jaowens14/GR-LRR-PCB/GR-LRR-ESTOP-PCB/electronics_libraries/S4B-XH-SM4-TB/S4B-XH-SM4-TB_LF__SN_.stp

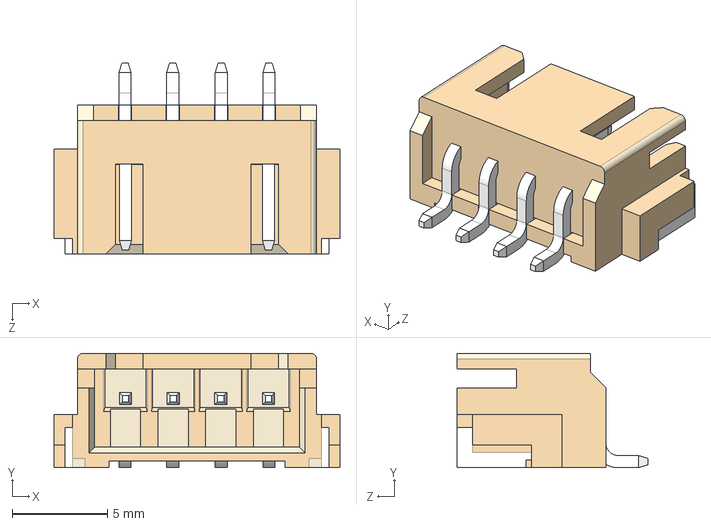
[picture p1: CAD file, 2023-12-06]
GR-LRR-ESTOP-PCB/electronics_libraries/S4B-XH-SM4-TB/S4B-XH-SM4-TB_LF__SN_.stp
15.0 x 6.00 x 10.0 mm
