jaowens14/GR-LRR-PCB/GR-LRR-POWER-PCB-HIGH-VOLTAGE/electronics_libraries/2604-1102/2604-1102.stp

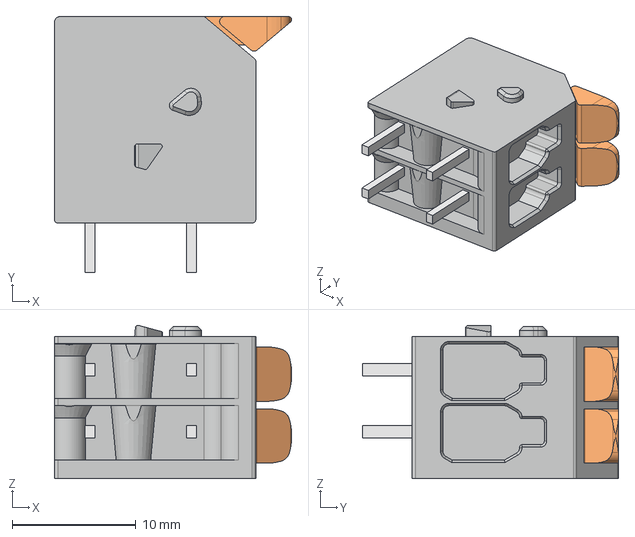
[picture p2: CAD file, 2023-10-17]
GR-LRR-POWER-PCB-HIGH-VOLTAGE/electronics_libraries/2604-1102/2604-1102.stp
19.2 x 20.7 x 12.4 mm
