jaowens14/GR-LRR-PCB/GR-LRR-POWER-PCB-HIGH-VOLTAGE/electronics_libraries/DF40HC(3.5)-80DS-0.4V(51)/DF40HC(3.5)-80DS.stp

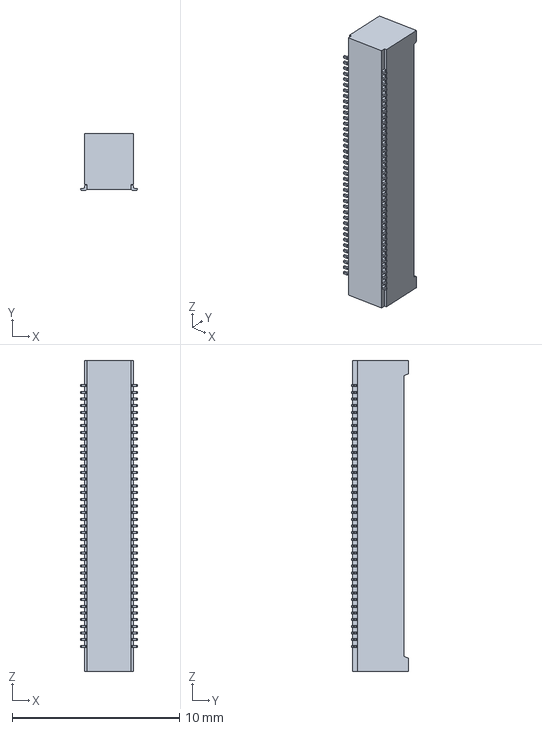
[picture p3: CAD file, 2023-10-17]
GR-LRR-POWER-PCB-HIGH-VOLTAGE/electronics_libraries/DF40HC(3.5)-80DS-0.4V(51)/DF40HC(3.5)-80DS.stp
3.38 x 3.40 x 18.6 mm
