jaowens14/GR-LRR-PCB/GR-LRR-POWER-PCB-HIGH-VOLTAGE/electronics_libraries/FX30B-4P-3.81DSA25/FX30B-4P-3.81DSA25.stp

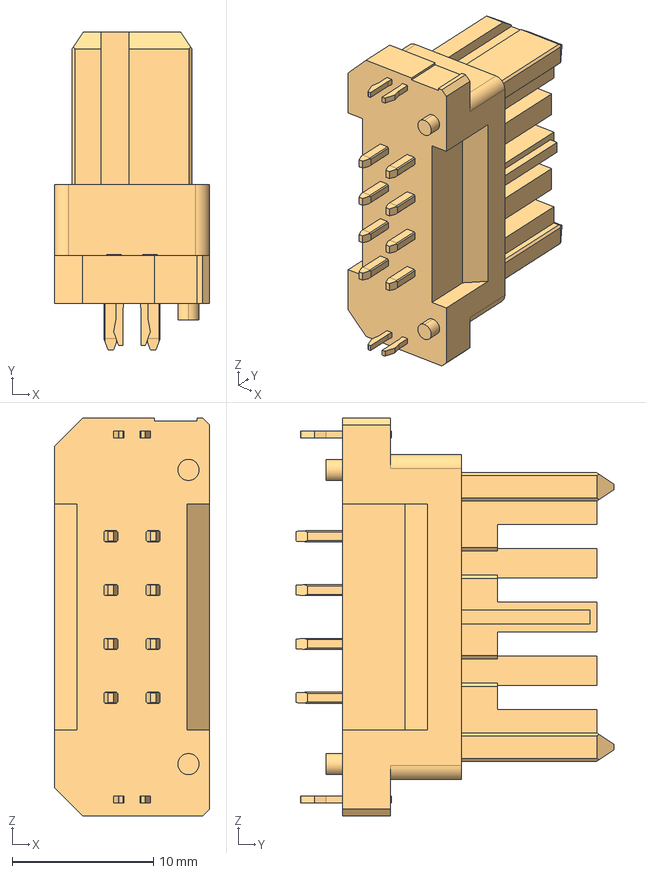
[picture p4: CAD file, 2023-12-06]
GR-LRR-POWER-PCB-HIGH-VOLTAGE/electronics_libraries/FX30B-4P-3.81DSA25/FX30B-4P-3.81DSA25.stp
11.0 x 22.5 x 28.2 mm
