jaowens14/GR-LRR-PCB/GR-LRR-POWER-PCB-HIGH-VOLTAGE/electronics_libraries/FX30B-4S-3.81DSA/FX30B-4S-3.81DSA.stp

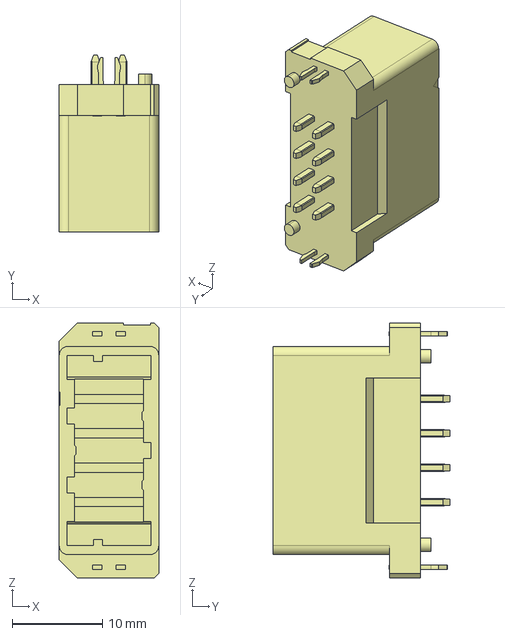
[picture p5: CAD file, 2023-12-06]
GR-LRR-POWER-PCB-HIGH-VOLTAGE/electronics_libraries/FX30B-4S-3.81DSA/FX30B-4S-3.81DSA.stp
11.0 x 19.6 x 28.2 mm
