jaowens14/GR-LRR-PCB/GR-LRR-POWER-PCB-HIGH-VOLTAGE/electronics_libraries/G5LE-14-DC5/G5LE-14-DC5.stp

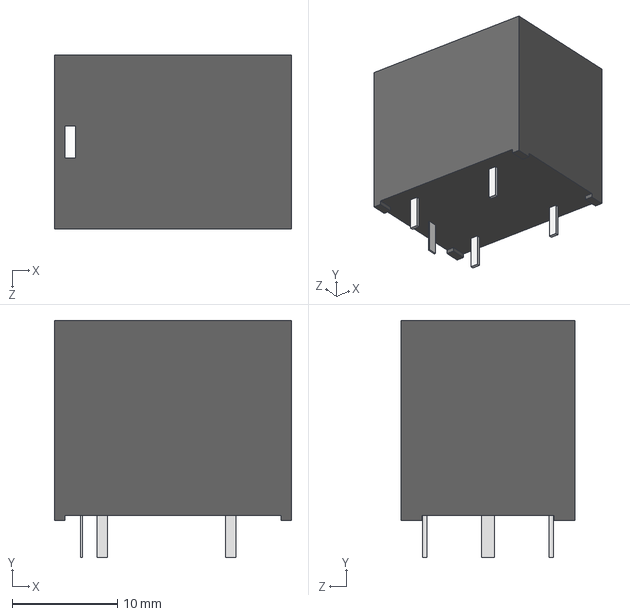
[picture p6: CAD file, 2023-10-31]
GR-LRR-POWER-PCB-HIGH-VOLTAGE/electronics_libraries/G5LE-14-DC5/G5LE-14-DC5.stp
22.5 x 22.5 x 16.5 mm
