jaowens14/GR-LRR-PCB/GR-LRR-POWER-PCB-HIGH-VOLTAGE/electronics_libraries/UWE-245-Q12PB-C/UWE-24_5-Q12PB-C.stp

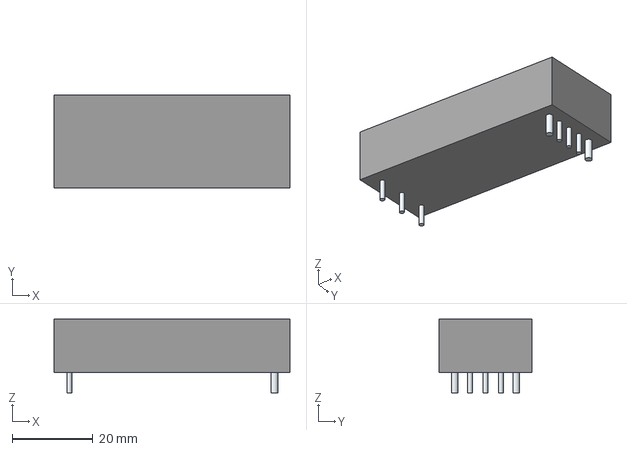
[picture p7: CAD file, 2023-10-31]
GR-LRR-POWER-PCB-HIGH-VOLTAGE/electronics_libraries/UWE-245-Q12PB-C/UWE-24_5-Q12PB-C.stp
58.4 x 22.9 x 18.3 mm
Leads
