jaowens14/GR-LRR-PCB/GR-LRR-POWER-PCB-HIGH-VOLTAGE/electronics_libraries/VSMA1085250/VSMA1085250.stp

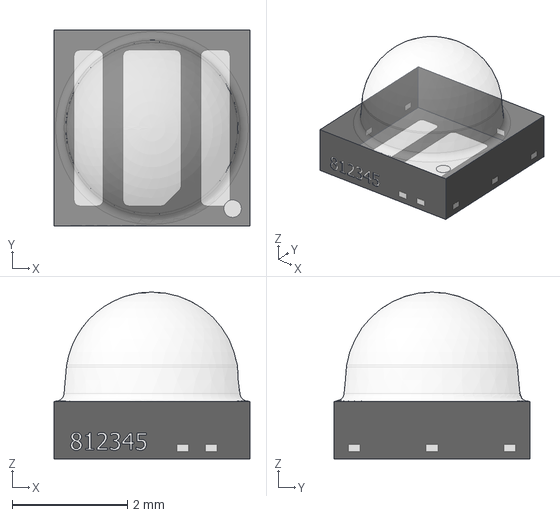
[picture p8: CAD file, 2023-10-17]
GR-LRR-POWER-PCB-HIGH-VOLTAGE/electronics_libraries/VSMA1085250/VSMA1085250.stp
3.40 x 3.40 x 2.90 mm
