jaowens14/GR-LRR-PCB/GR-LRR-POWER-PCB-HIGH-VOLTAGE/electronics_libraries/XA1E-BV302-R/XA1E-BV302-R.stp

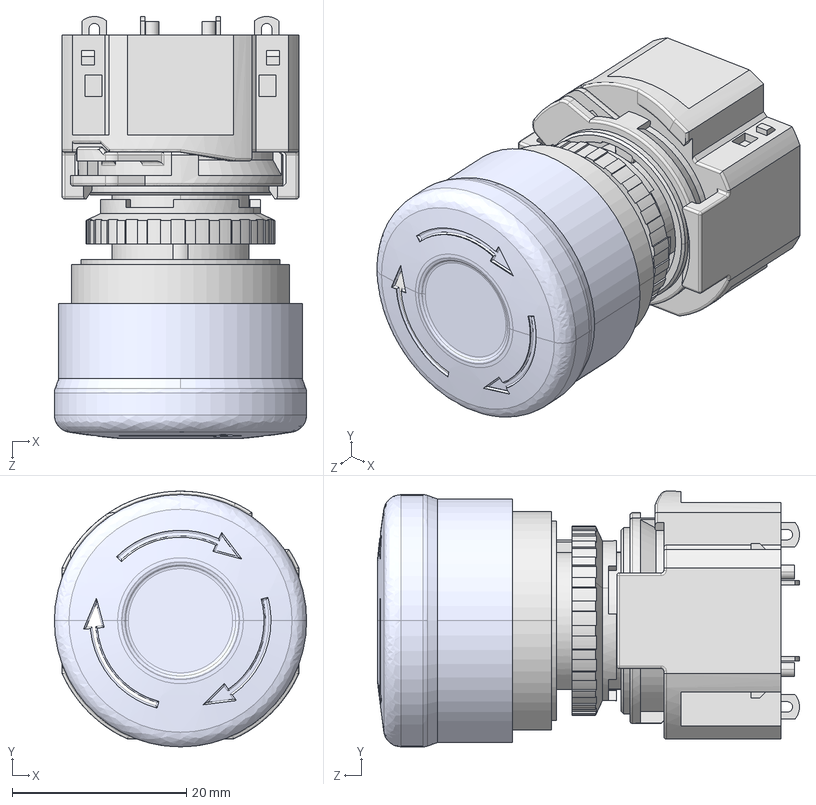
[picture p9: CAD file, 2023-10-31]
GR-LRR-POWER-PCB-HIGH-VOLTAGE/electronics_libraries/XA1E-BV302-R/XA1E-BV302-R.stp
29.0 x 29.4 x 48.5 mm
XA-BODY-V-Y
XA-HANDLE-[B][L]V
XA-LOCK-NUT
XA-Cxx
