jaowens14/GR-LRR-PCB/GR-LRR-POWER-PCB-HIGH-VOLTAGE/GR-LRR-POWER-PCB-HIGH-VOLTAGE.SLDPRT

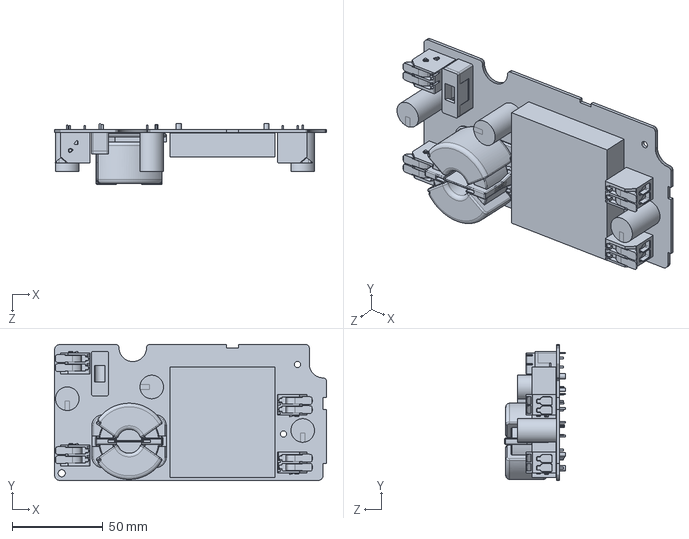
[picture p10: CAD file, 2024-03-25]
GR-LRR-POWER-PCB-HIGH-VOLTAGE/GR-LRR-POWER-PCB-HIGH-VOLTAGE.SLDPRT
150.0 x 75.0 x 33.5 mm
