jaowens14/GR-LRR-PCB/GR-LRR-POWER-PCB-INPUT/electronics_libraries/SISB46DN-T1-GE3/SISB46DN-T1-GE3.stp

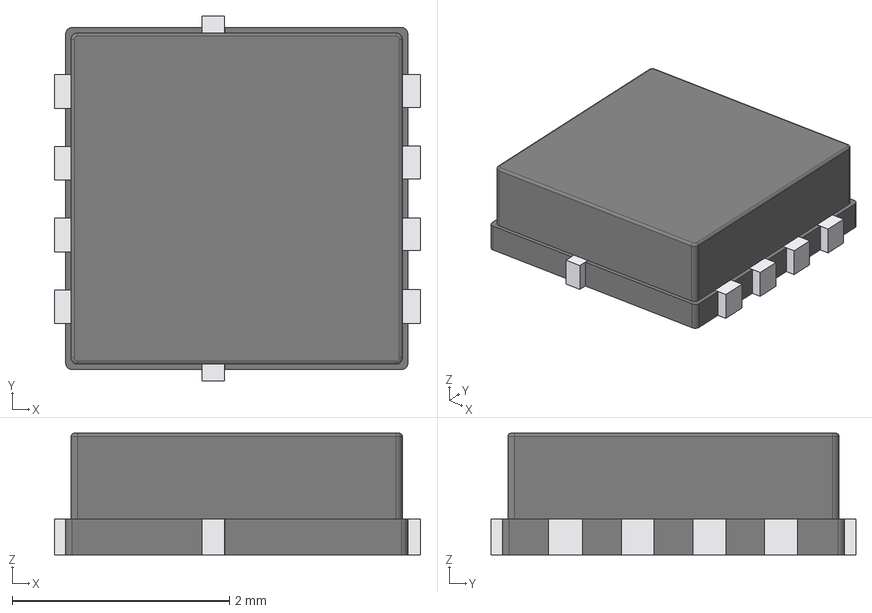
[picture p11: CAD file, 2024-03-25]
GR-LRR-POWER-PCB-INPUT/electronics_libraries/SISB46DN-T1-GE3/SISB46DN-T1-GE3.stp
3.37 x 3.36 x 1.12 mm
