jaowens14/GR-LRR-PCB/GR-LRR-POWER-PCB-LOW-VOLTAGE/electronics_libraries/UEI15-033-Q12P-C/UEI15-033-Q12P-C.stp

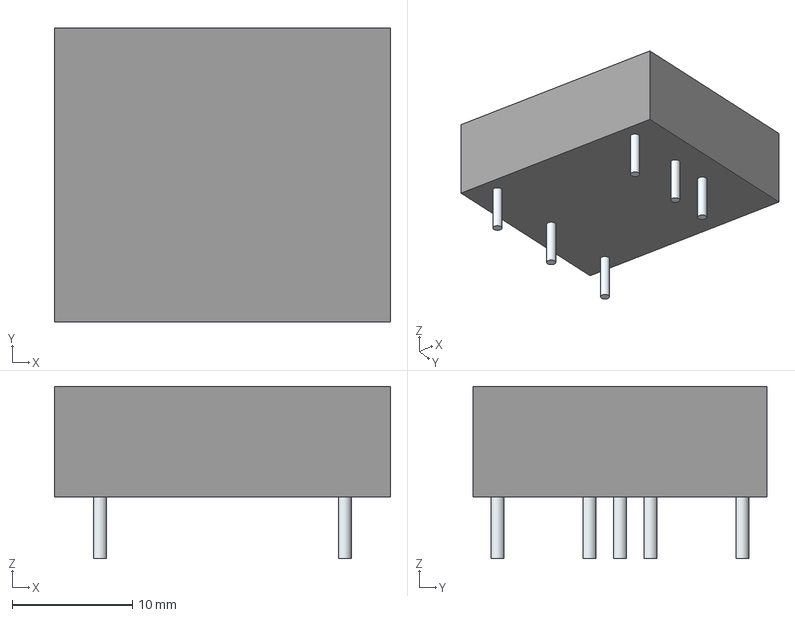
[picture p12: CAD file, 2024-03-25]
GR-LRR-POWER-PCB-LOW-VOLTAGE/electronics_libraries/UEI15-033-Q12P-C/UEI15-033-Q12P-C.stp
27.9 x 24.4 x 14.3 mm
Leads
