jaowens14/GR-LRR-PCB/GR-LRR-POWER-PCB-LOW-VOLTAGE/electronics_libraries/UWS-510-Q12P-C/UWS-510-Q12P-C.stp

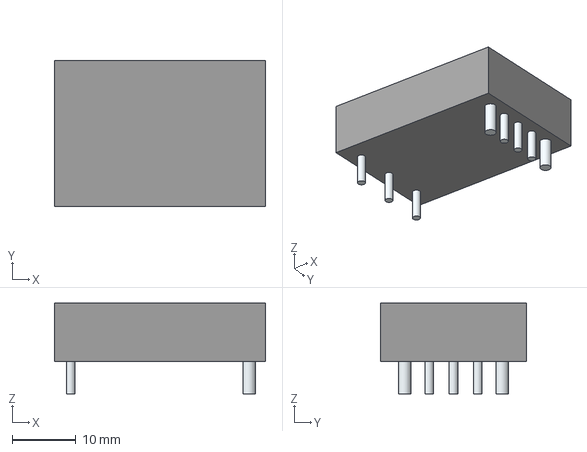
[picture p13: CAD file, 2024-03-25]
GR-LRR-POWER-PCB-LOW-VOLTAGE/electronics_libraries/UWS-510-Q12P-C/UWS-510-Q12P-C.stp
33.0 x 22.9 x 14.2 mm
Leads x 8
