jaowens14/GR-LRR-PCB/GR-LRR-POWER-PCB-LOW-VOLTAGE/GR-LRR-POWER-PCB.SLDPRT

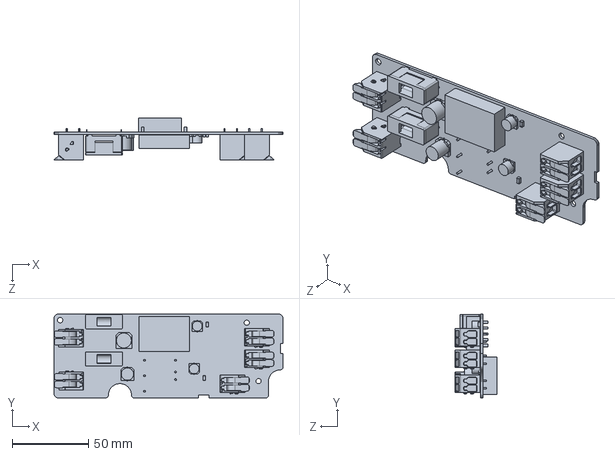
[picture p14: CAD file, 2024-03-25]
GR-LRR-POWER-PCB-LOW-VOLTAGE/GR-LRR-POWER-PCB.SLDPRT
150.0 x 55.0 x 27.7 mm
