jaowens14/GR-LRR-PCB/GR-LRR-POWER/GR-LRR-POWER.step

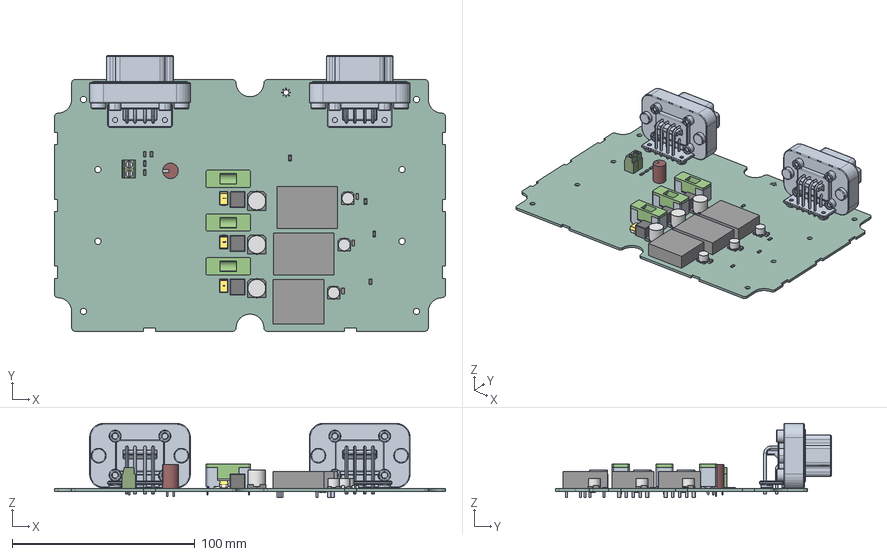
[picture p15: CAD file, 2024-08-06]
GR-LRR-POWER/GR-LRR-POWER.step
213.7 x 150.7 x 40.5 mm
CTSM_TCM2NKKO_7343_L7.6W4.6H4.3T0.13S1.3F2.5A3.6B0.65P1.7R1X0.2 x 3
R_1206_3216Metric x 11
696108003002 (rev1) x 3
ASSEMBLY x 3
C-DT13-08PB x 2
C_1206_3216Metric x 3
CQ assembly x 3
GR-LRR-POWER_PCB
