jaowens14/GR-LRR-PCB/(list of files, cad)

Other CAD files:
GR-LRR-POWER-PCB-HIGH-VOLTAGE/electronics_libraries/047700/047700.stp
GR-LRR-POWER-PCB-HIGH-VOLTAGE/electronics_libraries/696108003002/696108003002.stp
GR-LRR-POWER-PCB-HIGH-VOLTAGE/electronics_libraries/QSB30024S24/QSB30024S24.stp
GR-LRR-POWER-PCB-HIGH-VOLTAGE/electronics_libraries/TPS61021ADSGR/TPS61021ADSGR.stp
GR-LRR-POWER-PCB-INPUT/electronics_libraries/047700/047700.stp
GR-LRR-POWER-PCB-INPUT/electronics_libraries/QSB30024S24/QSB30024S24.stp
GR-LRR-POWER-PCB-INPUT/electronics_libraries/TPS61021ADSGR/TPS61021ADSGR.stp
GR-LRR-POWER-PCB-LOW-VOLTAGE/electronics_libraries/047700/047700.stp
GR-LRR-POWER-PCB-LOW-VOLTAGE/electronics_libraries/696108003002/696108003002.stp
GR-LRR-POWER-PCB-LOW-VOLTAGE/electronics_libraries/QSB30024S24/QSB30024S24.stp
GR-LRR-POWER-PCB-LOW-VOLTAGE/electronics_libraries/TPS61021ADSGR/TPS61021ADSGR.stp
OLD REVS/GR-LRR-CONTROL-PCB/electronics_libraries/047700/047700.stp
OLD REVS/GR-LRR-CONTROL-PCB/electronics_libraries/10018783_10101TLF/10018783-10101TLF.step
OLD REVS/GR-LRR-CONTROL-PCB/electronics_libraries/100PX220MEFC12.5X20/CAP_PKPZ_12P5X20_LOW_RUB.step
OLD REVS/GR-LRR-CONTROL-PCB/electronics_libraries/212520-1002/212520-1002.stp
OLD REVS/GR-LRR-CONTROL-PCB/electronics_libraries/2601_1112/2601-1112.stp
OLD REVS/GR-LRR-CONTROL-PCB/electronics_libraries/2604-3108/2604-3108.stp
OLD REVS/GR-LRR-CONTROL-PCB/electronics_libraries/43045-0212/43045-0212.stp
OLD REVS/GR-LRR-CONTROL-PCB/electronics_libraries/43045-1012/43045-1012.stp
OLD REVS/GR-LRR-CONTROL-PCB/electronics_libraries/50ZLH100MEFC8X11_5/CAP_YX_8X11P5_RUB.step
OLD REVS/GR-LRR-CONTROL-PCB/electronics_libraries/696108003002/696108003002.stp
OLD REVS/GR-LRR-CONTROL-PCB/electronics_libraries/736-112/736-112.stp
OLD REVS/GR-LRR-CONTROL-PCB/electronics_libraries/87831-1019/87831-1019.stp
OLD REVS/GR-LRR-CONTROL-PCB/electronics_libraries/CAY16_221J4LF/CAY16_221J4LF.step
OLD REVS/GR-LRR-CONTROL-PCB/electronics_libraries/DT13-2P/DT13-2P.stp
OLD REVS/GR-LRR-CONTROL-PCB/electronics_libraries/IHLP1212AEERR33M11/IHLP1212AEERR33M11.STEP
OLD REVS/GR-LRR-CONTROL-PCB/electronics_libraries/INA260AIPWR/INA260AIPWR.stp
OLD REVS/GR-LRR-CONTROL-PCB/electronics_libraries/IPB107N20N3_G/IPB107N20N3_G.stp
OLD REVS/GR-LRR-CONTROL-PCB/electronics_libraries/LTC4365CTS8_TRMPBF/LTC4365CTS8_TRMPBF.step
OLD REVS/GR-LRR-CONTROL-PCB/electronics_libraries/PCA9685PW/PCA9685PW.step
OLD REVS/GR-LRR-CONTROL-PCB/electronics_libraries/PYBE20-Q24-S5/PYBE20-Q24-S5.step
OLD REVS/GR-LRR-CONTROL-PCB/electronics_libraries/QSB30024S24/QSB30024S24.stp
OLD REVS/GR-LRR-CONTROL-PCB/electronics_libraries/SD03H0SB/SD03H0SB.step
OLD REVS/GR-LRR-CONTROL-PCB/electronics_libraries/T521X336M050ATE075/T521X336M050ATE075.step
OLD REVS/GR-LRR-CONTROL-PCB/electronics_libraries/TJA1049T,118/TJA1049T,118.stp
OLD REVS/GR-LRR-CONTROL-PCB/electronics_libraries/TPS61021ADSGR/TPS61021ADSGR.stp
OLD REVS/GR-LRR-CONTROL-PCB/electronics_libraries/UWS-24_2-Q12P-C/UWS-24_2-Q12P-C.stp
OLD REVS/GR-LRR-CONTROL-PCB/electronics_libraries/UWT1H101MNL1GS/UWT1H101MNL1GS.step
OLD REVS/GR-LRR-CONTROL-PCB/electronics_libraries/UWT1H221MNL1GS/UWT1H221MNL1GS.step
OLD REVS/GR-LRR-CONTROL-PCB/electronics_libraries/UWZ1H100MCL1GB/UWZ1H100MCL1GB.step
OLD REVS/GR-LRR-CONTROL-PCB/electronics_libraries/XB3-24AST-J/55001998-04-PRT.STEP
OLD REVS/GR-LRR-CONTROL-PCB/electronics_libraries/ul_ATTINY85V-10MU 3D MODEL/2022-03-24_22-57-11/STEP/20M1_ATM.step
OLD REVS/GR-LRR-ESTOP-PCB/electronics_libraries/047700/047700.stp
OLD REVS/GR-LRR-ESTOP-PCB/electronics_libraries/10018783_10101TLF/10018783-10101TLF.step
OLD REVS/GR-LRR-ESTOP-PCB/electronics_libraries/100PX220MEFC12.5X20/CAP_PKPZ_12P5X20_LOW_RUB.step
OLD REVS/GR-LRR-ESTOP-PCB/electronics_libraries/10164359_00011LF/10164359-00011LF.STEP
OLD REVS/GR-LRR-ESTOP-PCB/electronics_libraries/212520-1002/212520-1002.stp
OLD REVS/GR-LRR-ESTOP-PCB/electronics_libraries/2601_1112/2601-1112.stp
OLD REVS/GR-LRR-ESTOP-PCB/electronics_libraries/2604-3108/2604-3108.stp
OLD REVS/GR-LRR-ESTOP-PCB/electronics_libraries/43045-0212/43045-0212.stp
OLD REVS/GR-LRR-ESTOP-PCB/electronics_libraries/43045-1012/43045-1012.stp
OLD REVS/GR-LRR-ESTOP-PCB/electronics_libraries/50ZLH100MEFC8X11_5/CAP_YX_8X11P5_RUB.step
OLD REVS/GR-LRR-ESTOP-PCB/electronics_libraries/696108003002/696108003002.stp
OLD REVS/GR-LRR-ESTOP-PCB/electronics_libraries/736-112/736-112.stp
OLD REVS/GR-LRR-ESTOP-PCB/electronics_libraries/87831-1019/87831-1019.stp
OLD REVS/GR-LRR-ESTOP-PCB/electronics_libraries/CAY16_221J4LF/CAY16_221J4LF.step
OLD REVS/GR-LRR-ESTOP-PCB/electronics_libraries/DT13-2P/DT13-2P.stp
OLD REVS/GR-LRR-ESTOP-PCB/electronics_libraries/IHLP1212AEERR33M11/IHLP1212AEERR33M11.STEP
OLD REVS/GR-LRR-ESTOP-PCB/electronics_libraries/INA260AIPWR/INA260AIPWR.stp
OLD REVS/GR-LRR-ESTOP-PCB/electronics_libraries/IPB107N20N3_G/IPB107N20N3_G.stp
OLD REVS/GR-LRR-ESTOP-PCB/electronics_libraries/LTC4365CTS8_TRMPBF/LTC4365CTS8_TRMPBF.step
OLD REVS/GR-LRR-ESTOP-PCB/electronics_libraries/PCA9685PW/PCA9685PW.step
OLD REVS/GR-LRR-ESTOP-PCB/electronics_libraries/PYBE20-Q24-S5/PYBE20-Q24-S5.step
OLD REVS/GR-LRR-ESTOP-PCB/electronics_libraries/QSB30024S24/QSB30024S24.stp
OLD REVS/GR-LRR-ESTOP-PCB/electronics_libraries/SD03H0SB/SD03H0SB.step
OLD REVS/GR-LRR-ESTOP-PCB/electronics_libraries/T521X336M050ATE075/T521X336M050ATE075.step
OLD REVS/GR-LRR-ESTOP-PCB/electronics_libraries/TJA1049T,118/TJA1049T,118.stp
OLD REVS/GR-LRR-ESTOP-PCB/electronics_libraries/TPS61021ADSGR/TPS61021ADSGR.stp
OLD REVS/GR-LRR-ESTOP-PCB/electronics_libraries/UWS-24_2-Q12P-C/UWS-24_2-Q12P-C.stp
OLD REVS/GR-LRR-ESTOP-PCB/electronics_libraries/UWT1H101MNL1GS/UWT1H101MNL1GS.step
OLD REVS/GR-LRR-ESTOP-PCB/electronics_libraries/UWT1H221MNL1GS/UWT1H221MNL1GS.step
OLD REVS/GR-LRR-ESTOP-PCB/electronics_libraries/UWZ1H100MCL1GB/UWZ1H100MCL1GB.step
OLD REVS/GR-LRR-ESTOP-PCB/electronics_libraries/XB3-24AST-J/55001998-04-PRT.STEP
OLD REVS/GR-LRR-ESTOP-PCB/electronics_libraries/ul_ATTINY85V-10MU 3D MODEL/2022-03-24_22-57-11/STEP/20M1_ATM.step
OLD REVS/GR-LRR-PCB_A1/electronics_libraries/047700/047700.stp
OLD REVS/GR-LRR-PCB_A1/electronics_libraries/10018783_10101TLF/10018783-10101TLF.step
OLD REVS/GR-LRR-PCB_A1/electronics_libraries/100PX220MEFC12.5X20/CAP_PKPZ_12P5X20_LOW_RUB.step
OLD REVS/GR-LRR-PCB_A1/electronics_libraries/10164359_00011LF/10164359-00011LF.STEP
OLD REVS/GR-LRR-PCB_A1/electronics_libraries/212520-1002/212520-1002.stp
OLD REVS/GR-LRR-PCB_A1/electronics_libraries/2601_1112/2601-1112.stp
OLD REVS/GR-LRR-PCB_A1/electronics_libraries/2604-3108/2604-3108.stp
OLD REVS/GR-LRR-PCB_A1/electronics_libraries/43045-0212/43045-0212.stp
OLD REVS/GR-LRR-PCB_A1/electronics_libraries/43045-1012/43045-1012.stp
OLD REVS/GR-LRR-PCB_A1/electronics_libraries/50ZLH100MEFC8X11_5/CAP_YX_8X11P5_RUB.step
OLD REVS/GR-LRR-PCB_A1/electronics_libraries/696108003002/696108003002.stp
OLD REVS/GR-LRR-PCB_A1/electronics_libraries/736-112/736-112.stp
OLD REVS/GR-LRR-PCB_A1/electronics_libraries/87831-1019/87831-1019.stp
OLD REVS/GR-LRR-PCB_A1/electronics_libraries/CAY16_221J4LF/CAY16_221J4LF.step
OLD REVS/GR-LRR-PCB_A1/electronics_libraries/DT13-2P/DT13-2P.stp
OLD REVS/GR-LRR-PCB_A1/electronics_libraries/IHLP1212AEERR33M11/IHLP1212AEERR33M11.STEP
OLD REVS/GR-LRR-PCB_A1/electronics_libraries/INA260AIPWR/INA260AIPWR.stp
OLD REVS/GR-LRR-PCB_A1/electronics_libraries/IPB107N20N3_G/IPB107N20N3_G.stp
OLD REVS/GR-LRR-PCB_A1/electronics_libraries/LTC4365CTS8_TRMPBF/LTC4365CTS8_TRMPBF.step
OLD REVS/GR-LRR-PCB_A1/electronics_libraries/PCA9685PW/PCA9685PW.step
OLD REVS/GR-LRR-PCB_A1/electronics_libraries/PYBE20-Q24-S5/PYBE20-Q24-S5.step
OLD REVS/GR-LRR-PCB_A1/electronics_libraries/QSB30024S24/QSB30024S24.stp
OLD REVS/GR-LRR-PCB_A1/electronics_libraries/SD03H0SB/SD03H0SB.step
OLD REVS/GR-LRR-PCB_A1/electronics_libraries/T521X336M050ATE075/T521X336M050ATE075.step
OLD REVS/GR-LRR-PCB_A1/electronics_libraries/TJA1049T,118/TJA1049T,118.stp
OLD REVS/GR-LRR-PCB_A1/electronics_libraries/TPS61021ADSGR/TPS61021ADSGR.stp
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
