jaowens14/GR-LRR-PCB/GR-LRR-POWER/GR-LRR-POWER.kicad_pcb

## KiCad design GR-LRR-POWER/GR-LRR-POWER.kicad_pcb (2024-08-06)

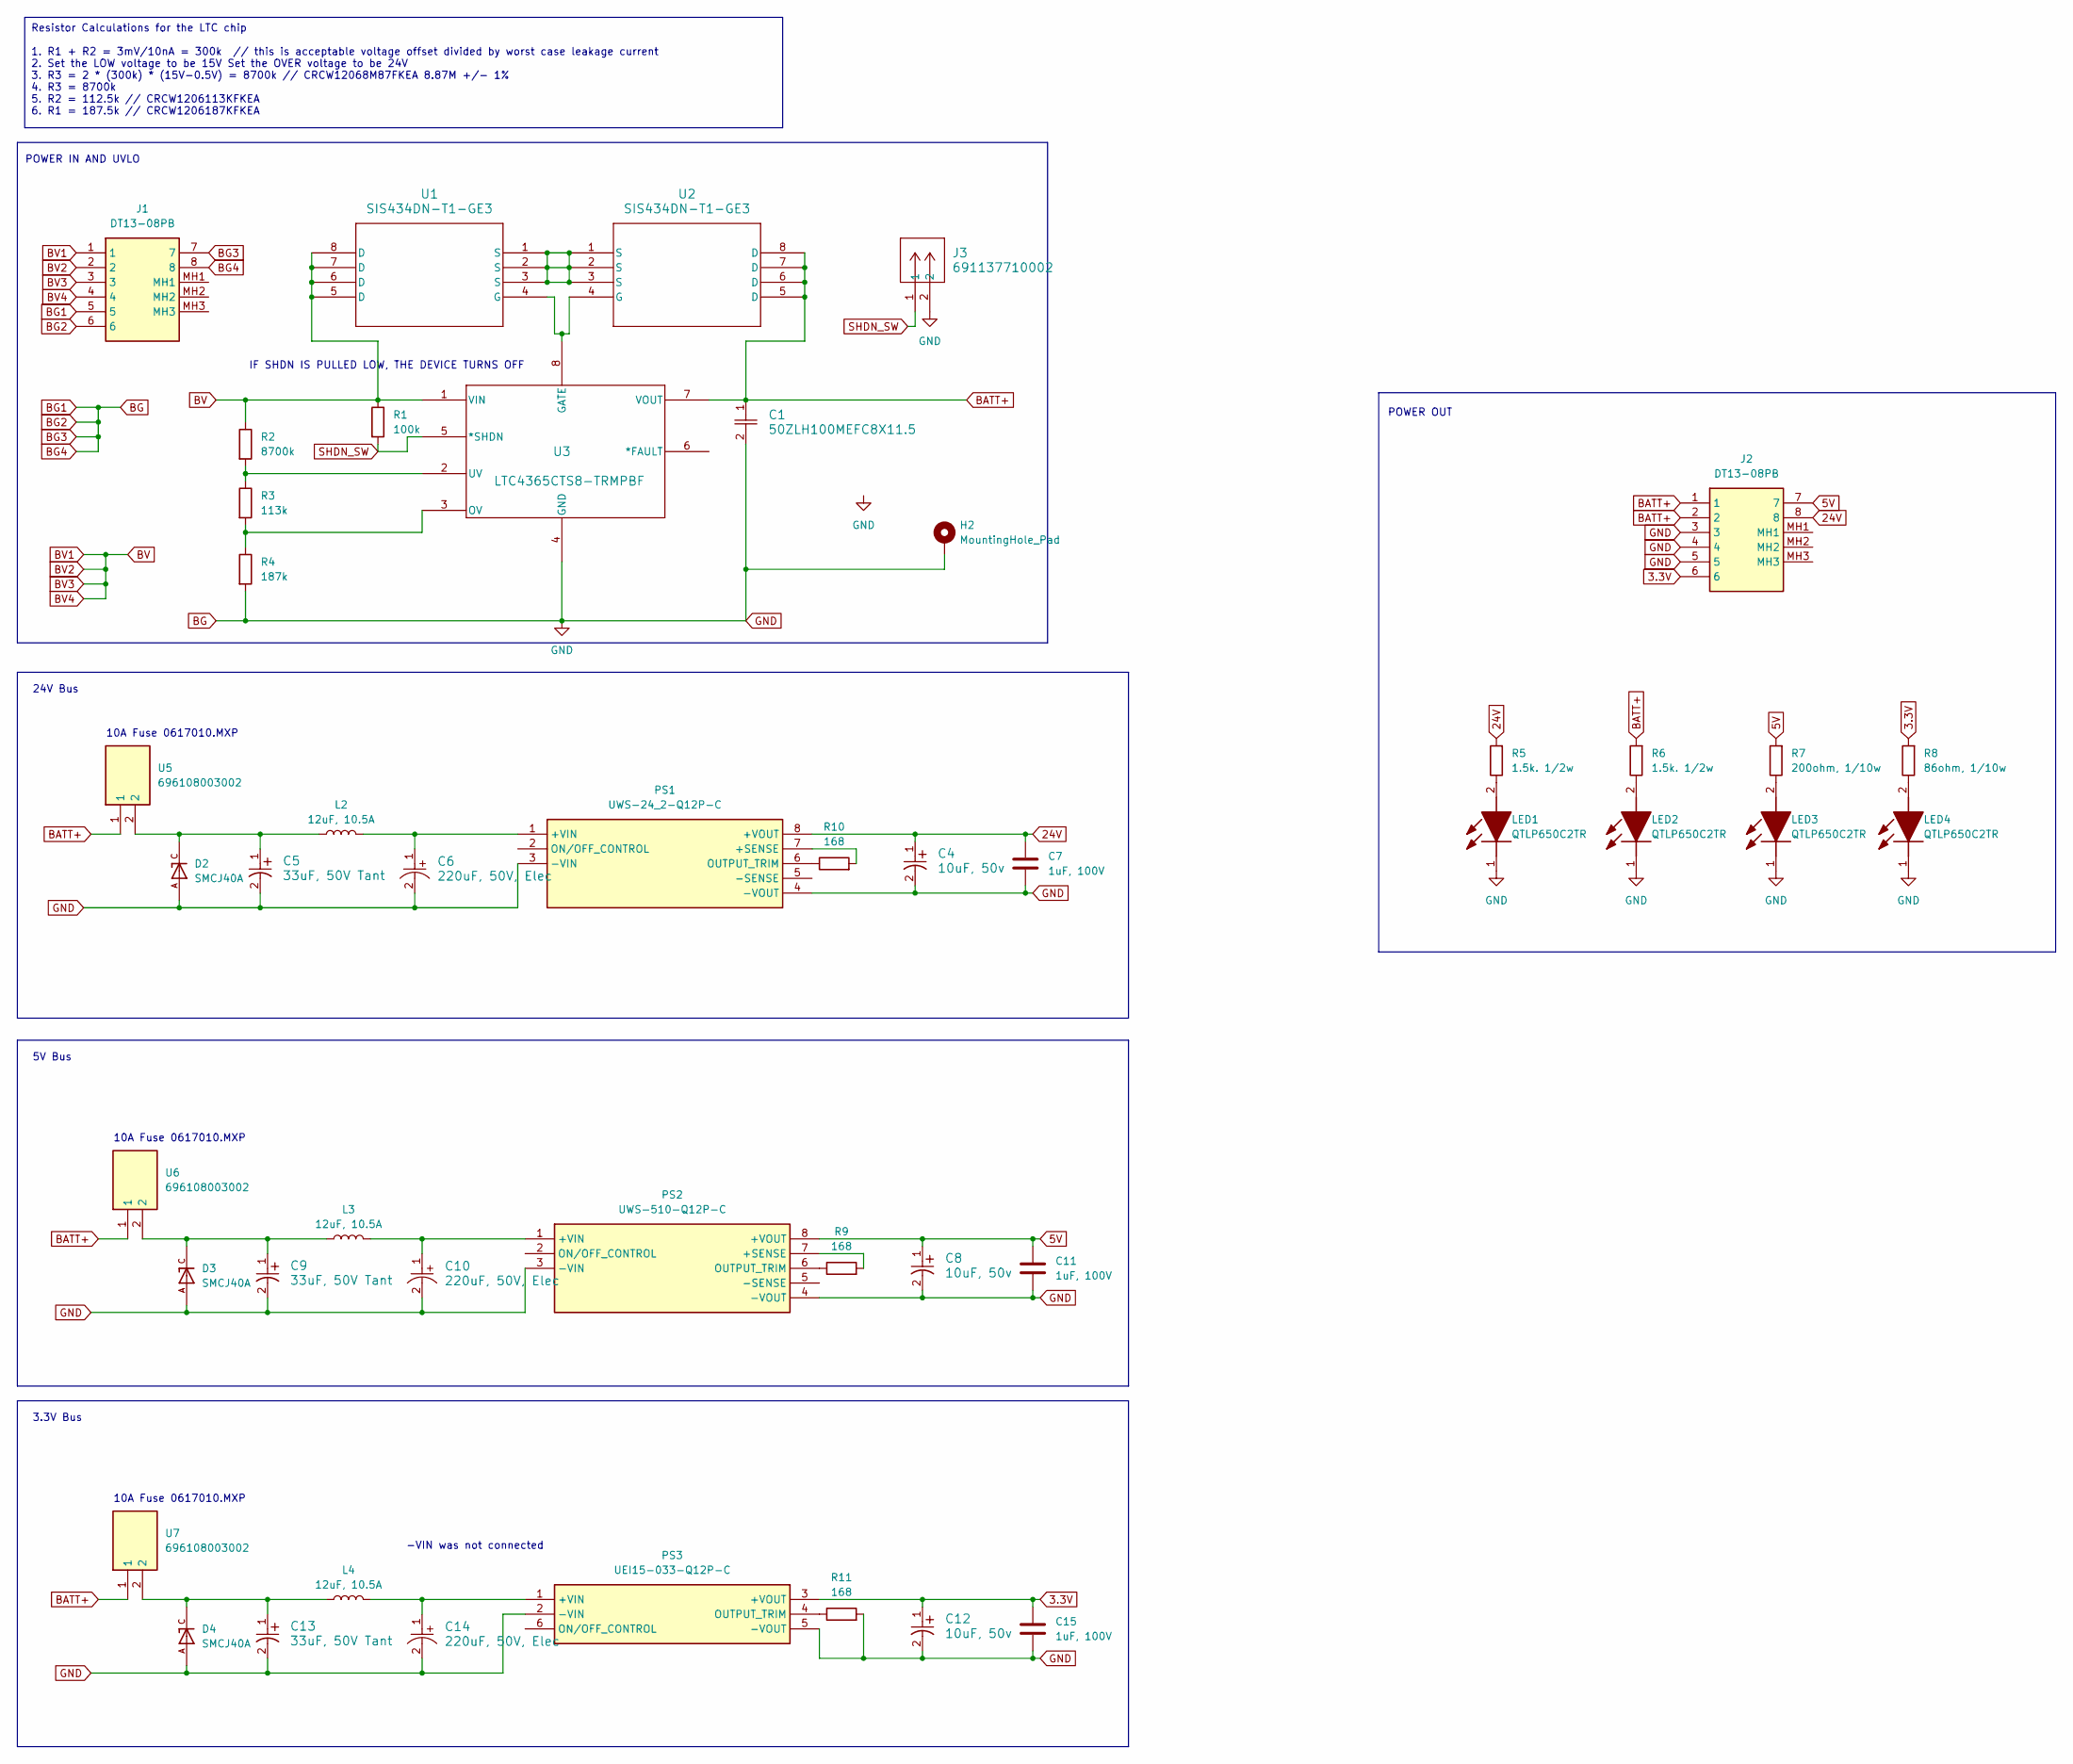
[picture p16: schematic GR-LRR-POWER.kicad_sch]

Parts:
C1: 50ZLH100MEFC8X11.5; 50ZLH100MEFC8X11_5; Part Number 50ZLH100MEFC8X11.5
C4, C8, C12: 10uF, 50v; PCAP_6.3x5.4-ELECT_NCA-L; Part Number UWZ1H100MCL1GB
C5, C9, C13: 33uF, 50V Tant; CAPMP7.6X4.3_4.3N_KEM-L; Part Number T521X336M050ATE050
C6, C10, C14: 220uF, 50V, Elec; U2-R_NCH-L; Part Number UWT1H221MNL1GS
C7, C11, C15: 1uF, 100V; C_1206_3216Metric_Pad1.33x1.80mm_HandSolder; Part Number CL31B105KCHNNNE
D2, D3, D4: SMCJ40A; DIOM7959X262N; PARTREV 11/20/15
H2: MountingHole_Pad; MountingHole_3mm_Pad_Via
J1, J2: DT13-08PB; DT1308PB; Mouser Part Number 571-DT13-08PB
J3: 691137710002; Part Number 691137710002
L2, L3, L4: 12uF, 10.5A; L_Coilcraft_XAL8080-XXX; Part Number XAL8080-123
LED1, LED2, LED3, LED4: QTLP650C2TR; LEDC3216X130N; Mouser Part Number 638-QTLP650C2
PS1: UWS-24_2-Q12P-C; UWS242Q12PC; Mouser Part Number 580-UWS-24/2-Q12P-C
PS2: UWS-510-Q12P-C; Mouser Part Number 580-UWS-15/3-Q12P-C
PS3: UEI15-033-Q12P-C; UEI15033Q12PC; Mouser Part Number 580-UEI15-033-Q12P-C
R1: 100k; R_1206_3216Metric_Pad1.30x1.75mm_HandSolder; Part Number CRCW12068M87FKEA
R2: 8700k; R_1206_3216Metric_Pad1.30x1.75mm_HandSolder; Part Number CRCW12068M87FKEA
R3: 113k; R_1206_3216Metric_Pad1.30x1.75mm_HandSolder; Part Number CRCW1206113KFKEA
R4: 187k; R_1206_3216Metric_Pad1.30x1.75mm_HandSolder; Part Number CRCW1206187KFKEA
R5, R6: 1.5k. 1/2w; R_1206_3216Metric_Pad1.30x1.75mm_HandSolder; Part Number RNCP1206FTD1K50
R7: 200ohm, 1/10w; R_1206_3216Metric_Pad1.30x1.75mm_HandSolder; Part Number RMCF1206JT200R
R8: 86ohm, 1/10w; R_1206_3216Metric_Pad1.30x1.75mm_HandSolder; Part Number RC1206FR-0786R6L
R9, R10, R11: 168; R_1206_3216Metric_Pad1.30x1.75mm_HandSolder
U1, U2: SIS434DN-T1-GE3; MOSFET_4DN-T1-E3_VIS; Part Number SIS434DN-T1-GE3
U3: LTC4365CTS8-TRMPBF; TSOT-23_TS8_LIT; Part Number LTC4365CTS8-TRMPBF
U5, U6, U7: 696108003002; WR-FSH_THT_2; Mouser Part Number 710-696108003002

Connections:
3.3V: C12.1, C15.1, J2.6, PS3.3 (+VOUT), R8.2
5V: C8.1, C11.1, J2.7, PS2.8 (+VOUT), R7.2
24V: C4.1, C7.1, J2.8, PS1.8 (+VOUT), R5.2
BATT+: C1.1, J2.1, J2.2, R6.2, U2.5 (D), U2.6 (D), U2.7 (D), U2.8 (D), U3.7 (VOUT), U5.1, U6.1, U7.1
BG: C1.2, C4.2, C5.2, C6.2, C7.2, C8.2, C9.2, C10.2, C11.2, C12.2, C13.2, C14.2, C15.2, D2.A, D3.A, D4.A, H2.1, J1.5, J1.6, J1.7, J1.8, J2.3, J2.4, J2.5, J3.2, LED1.1 (K), LED2.1 (K), LED3.1 (K), LED4.1 (K), PS1.3 (-VIN), PS1.4 (-VOUT), PS2.3 (-VIN), PS2.4 (-VOUT), PS3.2 (-VIN), PS3.5 (-VOUT), R4.2, R11.2, U3.4 (GND)
BV: J1.1, J1.2, J1.3, J1.4, R1.1, R2.1, U1.5 (D), U1.6 (D), U1.7 (D), U1.8 (D), U3.1 (VIN)
unnamed: C5.1, D2.C, L2.1, U5.2
unnamed: C9.1, D3.C, L3.1, U6.2
unnamed: C13.1, D4.C, L4.1, U7.2
unnamed: LED1.2 (A), R5.1
unnamed: LED2.2 (A), R6.1
unnamed: LED3.2 (A), R7.1
unnamed: LED4.2 (A), R8.1
unnamed: PS1.7 (+SENSE), R10.2
unnamed: C6.1, L2.2, PS1.1 (+VIN)
unnamed: PS1.6 (OUTPUT_TRIM), R10.1
unnamed: PS2.7 (+SENSE), R9.2
unnamed: C10.1, L3.2, PS2.1 (+VIN)
unnamed: PS2.6 (OUTPUT_TRIM), R9.1
unnamed: C14.1, L4.2, PS3.1 (+VIN)
unnamed: PS3.4 (OUTPUT_TRIM), R11.1
unnamed: U1.4 (G), U2.4 (G), U3.8 (GATE)
unnamed: U1.1 (S), U1.2 (S), U1.3 (S), U2.1 (S), U2.2 (S), U2.3 (S)
unnamed: R3.2, R4.1, U3.3 (OV)
unnamed: R2.2, R3.1, U3.2 (UV)
SHDN_SW: J3.1, R1.2, U3.5 (*SHDN)

Notes on the sheet:
Resistor Calculations for the LTC chip 1. R1 + R2 = 3mV/10nA = 300k // this is acceptable voltage offset divided by worst case leakage current 2. Set the LOW voltage to be 15V Set the OVER voltage to be 24V 3. R3 = 2 * (300k) * (15V-0.5V) = 8700k // CRCW12068M87FKEA 8.87M +/- 1% 4. R3 = 8700k 5. R2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
10A Fuse 0617010.MXP
3.3V Bus
POWER IN AND UVLO
POWER OUT
24V Bus
5V Bus
-VIN was not connected
IF SHDN IS PULLED LOW, THE DEVICE TURNS OFF

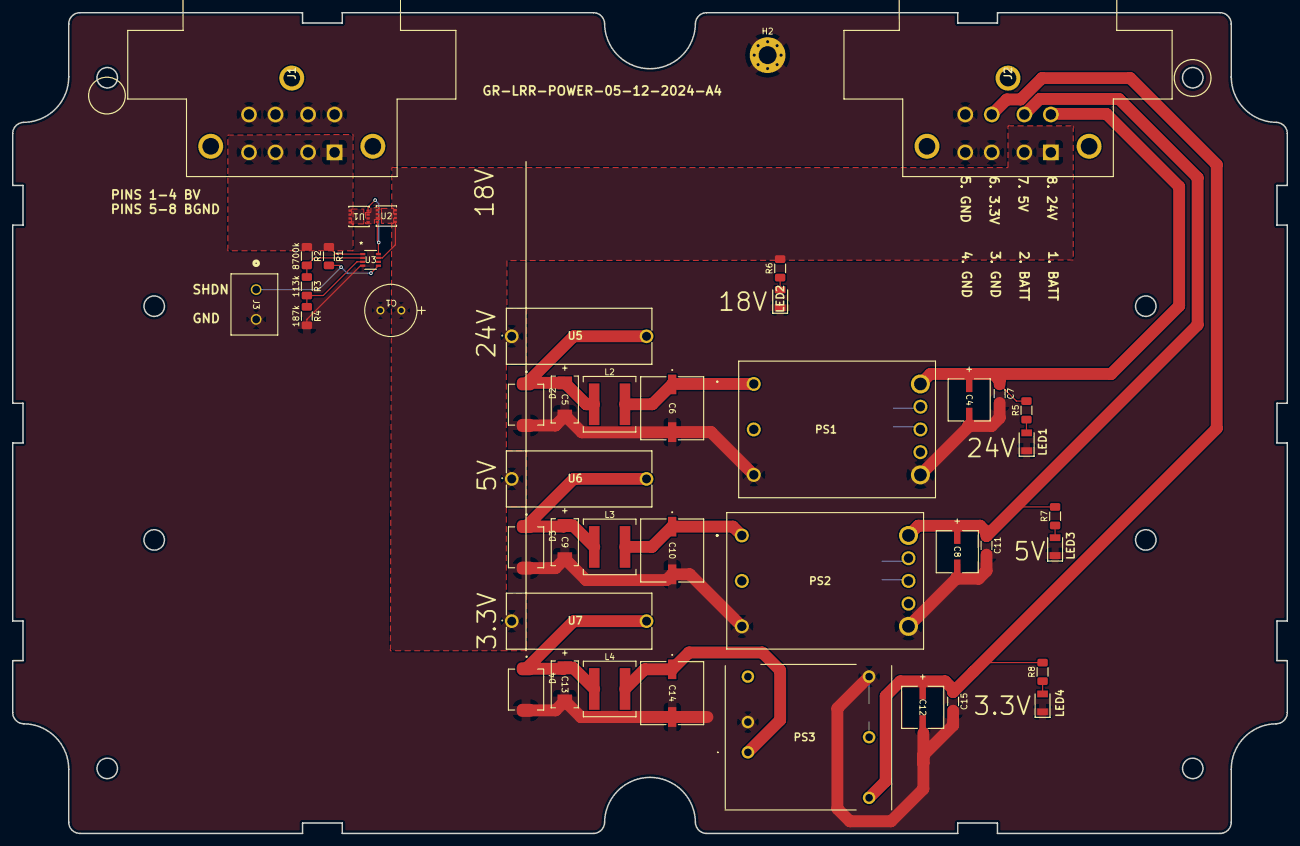
[picture p17: board GR-LRR-POWER.kicad_pcb from above]

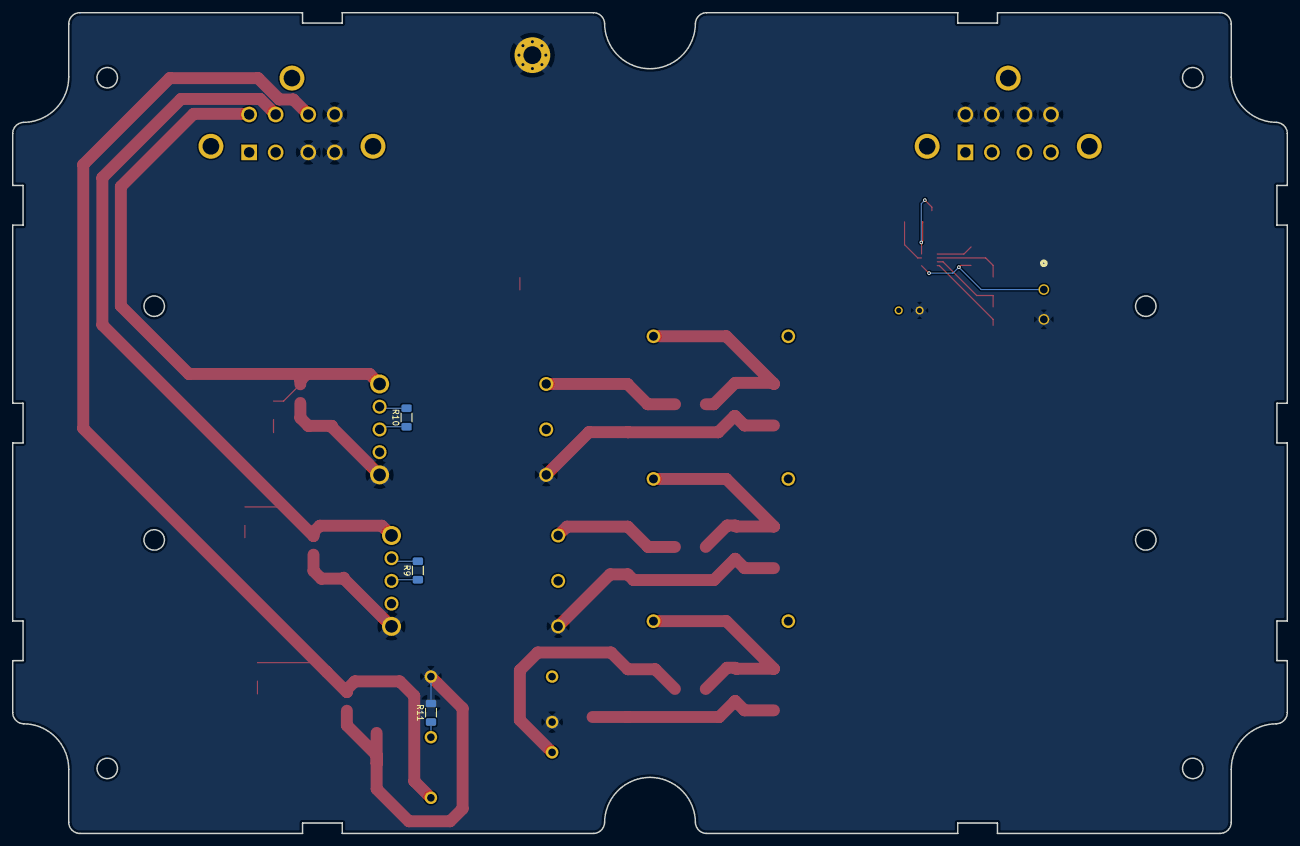
[picture p18: board GR-LRR-POWER.kicad_pcb from below]

Board: 2 copper layers, 213.7 x 137.6 mm, 47 parts (3 on the bottom side), 26 nets.
