jaowens14/GR-LRR-PCB/GR-LRR-GLUE-SHOVEL/GR-LRR-GLUE-SHOVEL.kicad_pcb

## KiCad design GR-LRR-GLUE-SHOVEL/GR-LRR-GLUE-SHOVEL.kicad_pcb (2024-05-12)

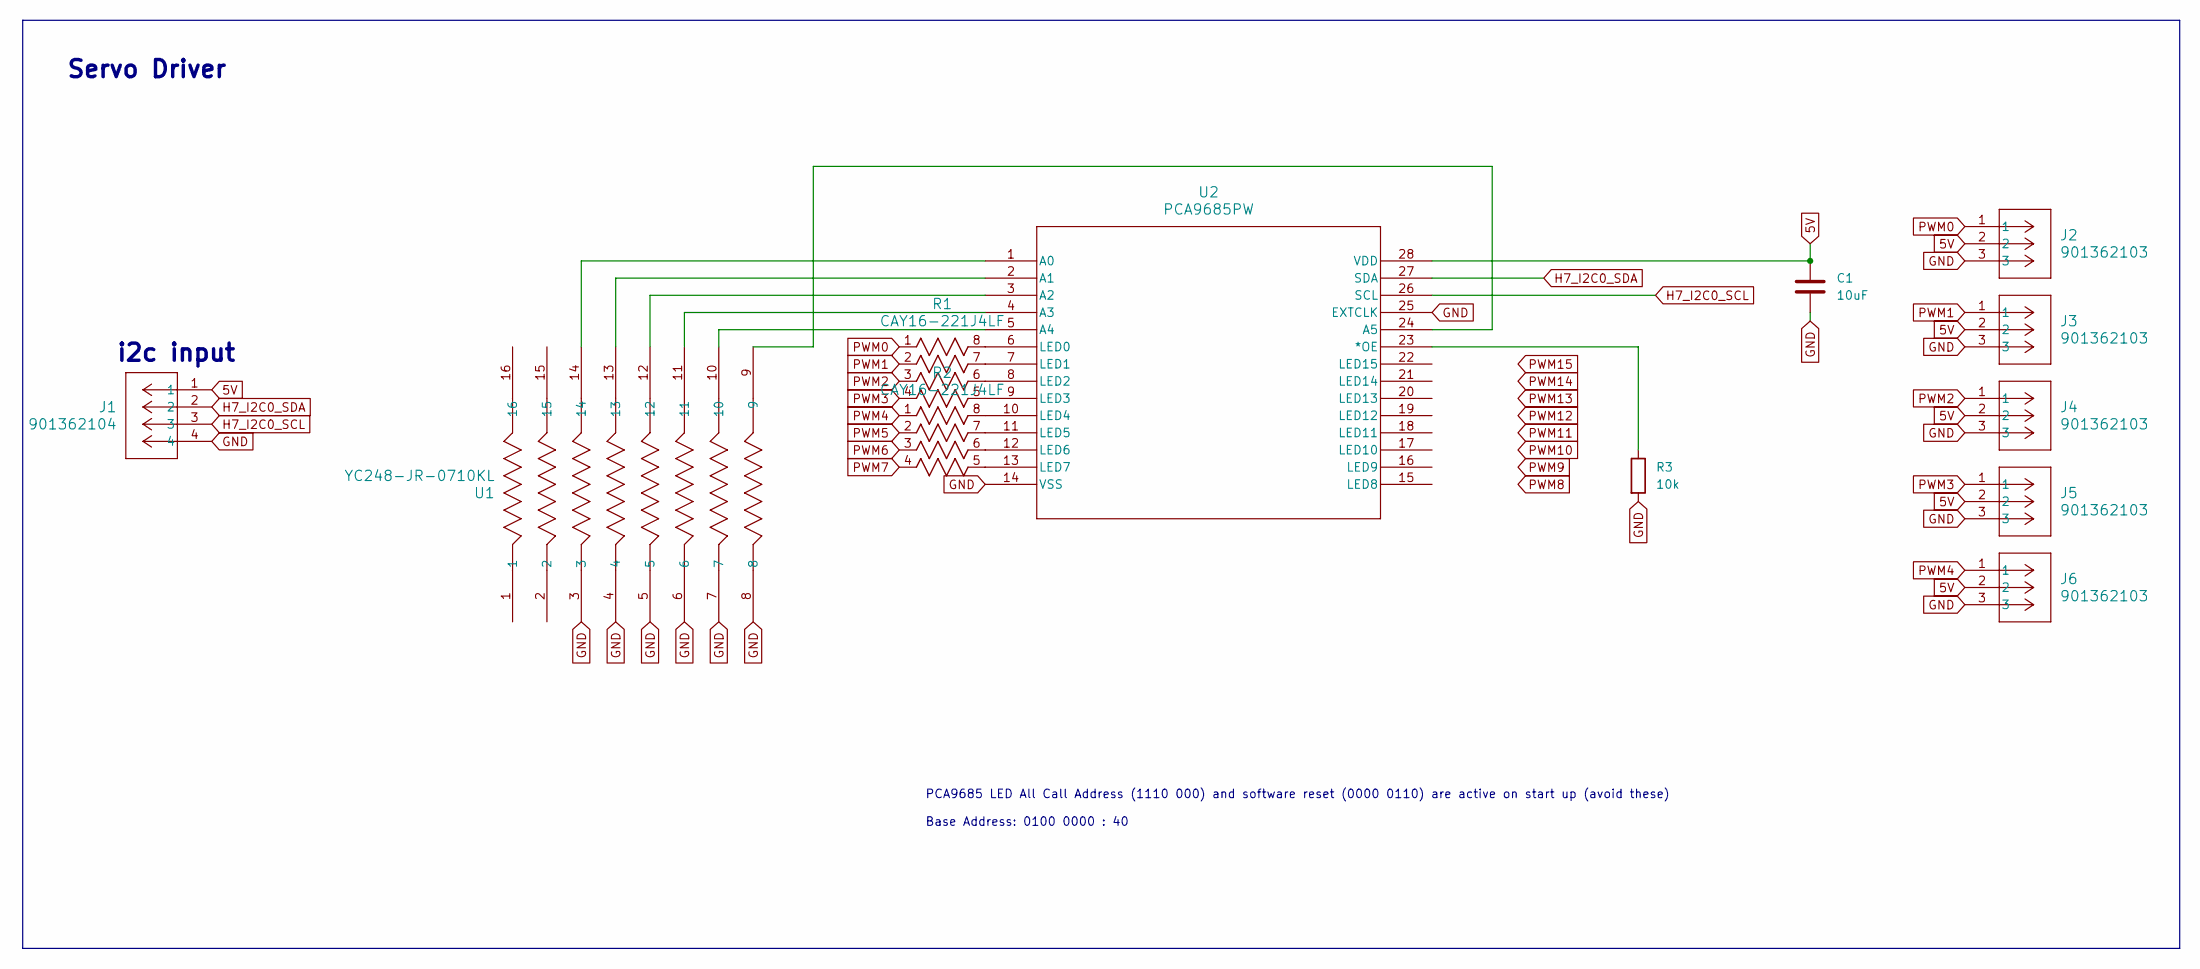
[picture p19: schematic GR-LRR-GLUE-SHOVEL.kicad_sch]

Parts:
C1: 10uF; C_1206_3216Metric_Pad1.33x1.80mm_HandSolder
J1: 901362104
J2, J3, J4, J5, J6: 901362103
R1, R2: CAY16-221J4LF; CAY16_221J4LF
R3: 10k; R_1206_3216Metric_Pad1.30x1.75mm_HandSolder
U1: YC248-JR-0710KL; RES_YC248_4X1P6_YAG
U2: PCA9685PW; SOT361-1_NXP

Connections:
5V: C1.1, J1.1, J2.2, J3.2, J4.2, J5.2, J6.2, U2.28 (VDD)
GND: C1.2, J1.4, J2.3, J3.3, J4.3, J5.3, J6.3, R3.2, U1.3, U1.4, U1.5, U1.6, U1.7, U1.8, U2.14 (VSS), U2.25 (EXTCLK)
H7_I2C0_SCL: J1.3, U2.26 (SCL)
H7_I2C0_SDA: J1.2, U2.27 (SDA)
unnamed: R3.1, U2.23 (*OE)
unnamed: U1.14, U2.1 (A0)
unnamed: U1.13, U2.2 (A1)
unnamed: U1.12, U2.3 (A2)
unnamed: U1.11, U2.4 (A3)
unnamed: U1.10, U2.5 (A4)
unnamed: U1.9, U2.24 (A5)
unnamed: R1.8, U2.6 (LED0)
unnamed: R1.7, U2.7 (LED1)
unnamed: R1.6, U2.8 (LED2)
unnamed: R1.5, U2.9 (LED3)
unnamed: R2.8, U2.10 (LED4)
unnamed: R2.7, U2.11 (LED5)
unnamed: R2.6, U2.12 (LED6)
unnamed: R2.5, U2.13 (LED7)
PWM0: J2.1, R1.1
PWM1: J3.1, R1.2
PWM2: J4.1, R1.3
PWM3: J5.1, R1.4
PWM4: J6.1, R2.1
PWM5: R2.2
PWM6: R2.3
PWM7: R2.4

Notes on the sheet:
PCA9685 LED All Call Address (1110 000) and software reset (0000 0110) are active on start up (avoid these) Base Address: 0100 0000 : 40
Servo Driver
i2c input

Board: 2 copper layers, 12 parts (0 on the bottom side), 24 nets, no tracks yet.
