jaowens14/GR-LRR-PCB/OLD REVS/GR-LRR-CONTROL-PCB/GR-LRR-CONTROL-PCB.kicad_pcb

## KiCad design OLD REVS/GR-LRR-CONTROL-PCB/GR-LRR-CONTROL-PCB.kicad_pcb (2024-05-12, an earlier design)

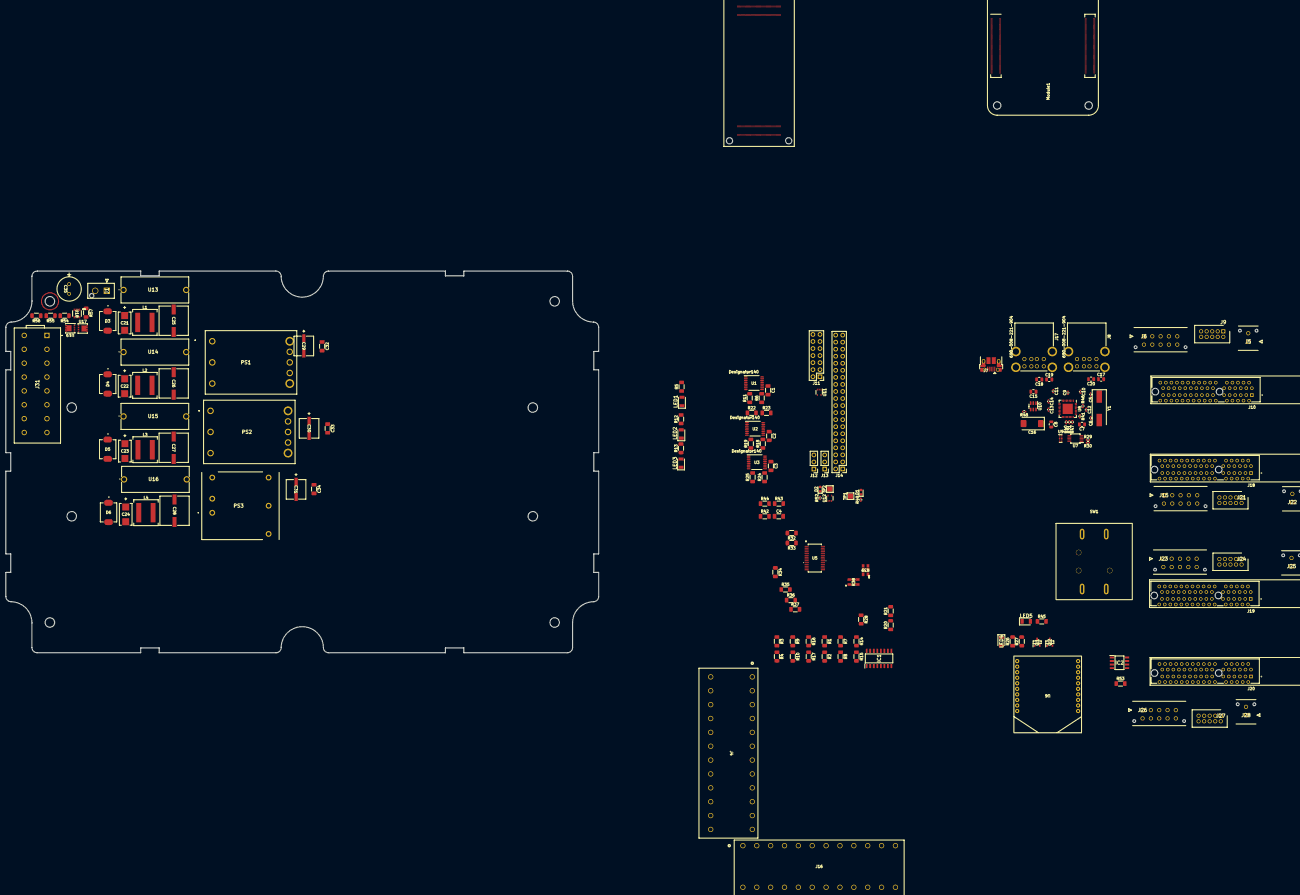
[picture p20: board GR-LRR-CONTROL-PCB.kicad_pcb from above]

Board: 2 copper layers, 213.7 x 137.6 mm, 163 parts (0 on the bottom side), 228 nets, no tracks yet.

Parts:
C1, C2, C3: 0.1uF; C_1206_3216Metric_Pad1.33x1.80mm_HandSolder
C4: 10uF; C_1206_3216Metric_Pad1.33x1.80mm_HandSolder
C5, C6: 27pF; C_0402_1005Metric
C7, C8, C15, C17, C18, C19, C20: 10u; C_0805_2012Metric
C9, C10, C11, C12, C13, C14: 100n; C_0402_1005Metric
C16: 100uF; CP_EIA-7343-31_Kemet-D
C21, C22, C23, C24: 33uF, 50V Tant; CAPMP7.6X4.3_4.3N_KEM
C25, C26, C27, C28: 220uF, 50V, Elec; U2-R_NCH
C29, C30, C31: 10uF, 50v; PCAP_6.3x5.4-ELECT_NCA
C32, C33, C34: 1uF, 100V; C_1206_3216Metric_Pad1.33x1.80mm_HandSolder
C35: 50ZLH100MEFC8X11.5; CAP_YX_8X11P5_RUB
D1: LED Green; LED_0603_1608Metric
D2: LED Red; LED_0603_1608Metric
D3, D4, D5, D6: SMCJ40A; DIOM7959X262N
IC1: MC1413DR2G; SOIC127P600X175-16N
IC2: TJA1049T,118
J1: Switch; 212520-1002
J4, J16: 736-112; CONN24_736-112_WAG
J5, J22, J25, J28: 43045-0212; 43045-02YY_121314
J6, J15, J23, J26: 43045-1012; 43045-10YY_121314
J7: USB_OTG; USB_Micro-B_EDAC_UCON00686
J8, J17: 690-008-221-904; MOLEX_USB_67298-4090
J9, J21, J24, J27: 87831-1019
J10, J18, J19, J20: 10018783-10101TLF; AMPHENOL_10018783-10101TLF
J11: Conn_02x07_Odd_Even; PinHeader_2x07_P2.54mm_Vertical
J12, J13: Conn_01x03; PinHeader_1x03_P2.54mm_Vertical
J14: THD-20-R; PinHeader_2x20_P2.54mm_Vertical
J31: 2604-3108; 26043108
L1, L2, L3, L4: 12uF, 10.5A; L_Coilcraft_XAL8080-XXX
LED1, LED2, LED3, LED4, LED5: QTLP650C2TR; LEDC3216X130N
Module1: ComputeModule4; Raspberry-Pi-4-Compute-Module
PS1: UWS-24_2-Q12P-C; UWS242Q12PC
PS2: UWS-510-Q12P-C
PS3: UEI15-033-Q12P-C; UEI15033Q12PC
Q1, Q2: BSS806NH6327XTSA1; SOT95P240X110-3N
R1, R3, R7, R9, R14, R16: 1k 1/8W; R_1206_3216Metric_Pad1.30x1.75mm_HandSolder
R2, R4, R8, R10, R15, R17: 2k 1/8w; R_1206_3216Metric_Pad1.30x1.75mm_HandSolder
R5: 1.5k. 1/2w; R_1206_3216Metric_Pad1.30x1.75mm_HandSolder
R6, R11, R18, R19, R24, R25, R32, R33, R34, R35, R36, R37, R42, R43, R44: 10k; R_1206_3216Metric_Pad1.30x1.75mm_HandSolder
R12: 200ohm, 1/10w; R_1206_3216Metric_Pad1.30x1.75mm_HandSolder
R13, R26, R45: 86ohm, 1/10w; R_1206_3216Metric_Pad1.30x1.75mm_HandSolder
R20: 4k; R_1206_3216Metric_Pad1.30x1.75mm_HandSolder
R21: 1k 1/8w; R_1206_3216Metric_Pad1.30x1.75mm_HandSolder
R22: 100k 1/8W; R_1206_3216Metric_Pad1.30x1.75mm_HandSolder
R23: 10k 1/8w; R_1206_3216Metric_Pad1.30x1.75mm_HandSolder
R27, R28: 10k 1/8W; R_1206_3216Metric_Pad1.30x1.75mm_HandSolder
R29, R30: 2.2K 1%; R_0402_1005Metric
R31, R40, R41, R47: 36K 1%; R_0402_1005Metric
R38, R39: CAY16-221J4LF; BO_CAY16
R46: 12K 1%; R_0402_1005Metric
R48: 15K 1%; R_0402_1005Metric
R49, R52: 1k; R_0402_1005Metric
R53: 120; R_1206_3216Metric_Pad1.30x1.75mm_HandSolder
R54: 8700k; R_1206_3216Metric_Pad1.30x1.75mm_HandSolder
R55: 113k; R_1206_3216Metric_Pad1.30x1.75mm_HandSolder
R56: 187k; R_1206_3216Metric_Pad1.30x1.75mm_HandSolder
R57: 100k; R_1206_3216Metric_Pad1.30x1.75mm_HandSolder
SW1: XA1E-BV302-R
TP1, TP2: TestPoint; TestPoint_Pad_2.0x2.0mm
U1, U2, U3: INA260AIPWR; PW0016A_N
U4: ABX00042; MODULE_ABX00042
U5: PCA9685PW; SOT361-1_NXP
U6: XB3-24AST-J
U7: FSUSB42MUX; MSOP-10_3x3mm_P0.5mm
U8: USB2514B-I/M2; QFN-36-1EP_6x6mm_P0.5mm_EP3.7x3.7mm
U9: TPD4EUSB30; USON-10_2.5x1.0mm_P0.5mm
U10: AP22653W6; SOT-23-6
U11, U12: 74LVC1G07SE-7; SOT-353_SC-70-5
U13, U14, U15, U16: 696108003002; WR-FSH_THT_2
U17, U19: SIS434DN-T1-GE3; MOSFET_4DN-T1-E3_VIS
U18: LTC4365CTS8-TRMPBF; TSOT-23_TS8_LIT
Y1: 24MHz; Crystal_SMD_HC49-SD

Connections:
3.3V: C31.1, C34.1, PS3.3 (+VOUT)
5V: C30.1, C33.1, PS2.8 (+VOUT)
18V: C25.1, L1.2
24V: C29.1, C32.1, PS1.8 (+VOUT)
73_ANALOG_A0: R22.2, R23.1, U4.J2_73 (ADC_A0)
75_ANALOG_A1: R20.2, R21.1, U4.J2_75 (ADC_A1)
+3.3V: IC2.5 (SPLIT), Q2.3 (D), R6.1, R11.1, R18.1, R19.1, R24.1, R25.1, R28.1, U3.14 (IN-), U3.15 (IN-), U3.16 (IN-), U6.1 (VCC)
+3.3V_IN: C1.2, C2.2, C3.2, R13.2, U1.10 (VS), U2.10 (VS), U3.1 (IN+), U3.2 (IN+), U3.3 (IN+), U3.5 (A0), U3.10 (VS), U3.12 (VBUS)
+5V: C4.1, IC2.3 (VCC), J4.1, J4.4, J4.7, J4.10, J4.13, J4.16, J4.19, J4.22, J16.15, J16.20, R42.1, R44.1, U2.14 (IN-), U2.15 (IN-), U2.16 (IN-), U4.J1_21 (VIN), U4.J1_41 (VIN), U5.28 (VDD)
+5V_IN: R12.2, U2.1 (IN+), U2.2 (IN+), U2.3 (IN+), U2.12 (VBUS)
+24V: J16.2, J16.4, J16.7, U1.14 (IN-), U1.15 (IN-), U1.16 (IN-)
+24V_IN: R5.2, U1.1 (IN+), U1.2 (IN+), U1.3 (IN+), U1.12 (VBUS)
/+3.3v: C7.1, C8.1, C9.1, C10.1, C11.1, C12.1, C13.1, C14.1, D1.2 (A), D2.2 (A), J14.1, J14.17, Module1.84 (+3.3v_(Output)), Module1.86 (+3.3v_(Output)), U7.1 (VCC), U8.5 (VDDA33), U8.10 (VDDA33), U8.15 (VDD33), U8.23 (VDD33), U8.27 (VBUS_DET), U8.29 (VDDA33), U8.36 (VDDA33), U12.5 (VCC)
/+5v: C15.1, J14.2, J14.4, Module1.77 (+5v_(Input)), Module1.79 (+5v_(Input)), Module1.81 (+5v_(Input)), Module1.83 (+5v_(Input)), Module1.85 (+5v_(Input)), Module1.87 (+5v_(Input)), U10.1 (IN), U11.5 (VCC)
/CM4_GPIO ( Ethernet, GPIO, SDCARD)/+1.8v: Module1.88 (+1.8v_(Output)), Module1.90 (+1.8v_(Output))
/CM4_GPIO ( Ethernet, GPIO, SDCARD)/AIN0: J11.5, Module1.96 (AnalogIP0)
/CM4_GPIO ( Ethernet, GPIO, SDCARD)/AIN1: J11.6, Module1.94 (AnalogIP1)
/CM4_GPIO ( Ethernet, GPIO, SDCARD)/BT_nDis: J12.3, Module1.91 (BT_nDisable)
/CM4_GPIO ( Ethernet, GPIO, SDCARD)/EEPROM_nWP: J11.4, Module1.20 (EEPROM_nWP)
/CM4_GPIO ( Ethernet, GPIO, SDCARD)/GLOBAL_EN: J11.14, J13.1, Module1.99 (Global_EN)
/CM4_GPIO ( Ethernet, GPIO, SDCARD)/GPIO2: J14.3, Module1.58 (GPIO2)
/CM4_GPIO ( Ethernet, GPIO, SDCARD)/GPIO3: J14.5, Module1.56 (GPIO3)
/CM4_GPIO ( Ethernet, GPIO, SDCARD)/GPIO4: J14.7, Module1.54 (GPIO4)
/CM4_GPIO ( Ethernet, GPIO, SDCARD)/GPIO5: J14.29, Module1.34 (GPIO5)
/CM4_GPIO ( Ethernet, GPIO, SDCARD)/GPIO6: J14.31, Module1.30 (GPIO6)
/CM4_GPIO ( Ethernet, GPIO, SDCARD)/GPIO7: J14.26, Module1.37 (GPIO7)
/CM4_GPIO ( Ethernet, GPIO, SDCARD)/GPIO8: J14.24, Module1.39 (GPIO8)
/CM4_GPIO ( Ethernet, GPIO, SDCARD)/GPIO9: J14.21, Module1.40 (GPIO9)
/CM4_GPIO ( Ethernet, GPIO, SDCARD)/GPIO10: J14.19, Module1.44 (GPIO10)
/CM4_GPIO ( Ethernet, GPIO, SDCARD)/GPIO11: J14.23, Module1.38 (GPIO11)
/CM4_GPIO ( Ethernet, GPIO, SDCARD)/GPIO12: J14.32, Module1.31 (GPIO12)
/CM4_GPIO ( Ethernet, GPIO, SDCARD)/GPIO13: J14.33, Module1.28 (GPIO13)
/CM4_GPIO ( Ethernet, GPIO, SDCARD)/GPIO16: J14.36, Module1.29 (GPIO16)
/CM4_GPIO ( Ethernet, GPIO, SDCARD)/GPIO17: J14.11, Module1.50 (GPIO17)
/CM4_GPIO ( Ethernet, GPIO, SDCARD)/GPIO18: J14.12, Module1.49 (GPIO18)
/CM4_GPIO ( Ethernet, GPIO, SDCARD)/GPIO19: J14.35, Module1.26 (GPIO19)
/CM4_GPIO ( Ethernet, GPIO, SDCARD)/GPIO20: J14.38, Module1.27 (GPIO20)
/CM4_GPIO ( Ethernet, GPIO, SDCARD)/GPIO21: J14.40, Module1.25 (GPIO21)
/CM4_GPIO ( Ethernet, GPIO, SDCARD)/GPIO22: J14.15, Module1.46 (GPIO22)
/CM4_GPIO ( Ethernet, GPIO, SDCARD)/GPIO23: J14.16, Module1.47 (GPIO23)
/CM4_GPIO ( Ethernet, GPIO, SDCARD)/GPIO24: J14.18, Module1.45 (GPIO24)
/CM4_GPIO ( Ethernet, GPIO, SDCARD)/GPIO25: J14.22, Module1.41 (GPIO25)
/CM4_GPIO ( Ethernet, GPIO, SDCARD)/GPIO26: J14.37, Module1.24 (GPIO26)
/CM4_GPIO ( Ethernet, GPIO, SDCARD)/GPIO27: J14.13, Module1.48 (GPIO27)
/CM4_GPIO ( Ethernet, GPIO, SDCARD)/ID_SC: J14.28, Module1.35 (ID_SC)
/CM4_GPIO ( Ethernet, GPIO, SDCARD)/ID_SD: J14.27, Module1.36 (ID_SD)
/CM4_GPIO ( Ethernet, GPIO, SDCARD)/RUN_PG: J13.3, Module1.92 (RUN_PG), U11.2
/CM4_GPIO ( Ethernet, GPIO, SDCARD)/SYNC_IN: J11.8, Module1.16 (Ethernet_SYNC_IN(1.8v))
/CM4_GPIO ( Ethernet, GPIO, SDCARD)/SYNC_OUT: J11.9, Module1.18 (Ethernet_SYNC_OUT(1.8v))
/CM4_GPIO ( Ethernet, GPIO, SDCARD)/TV_OUT: J11.11, Module1.111 (VDAC_COMP)
/CM4_GPIO ( Ethernet, GPIO, SDCARD)/WL_nDis: J12.1, Module1.89 (WL_nDisable)
/CM4_GPIO ( Ethernet, GPIO, SDCARD)/nPWR_LED: Module1.95 (nPI_LED_PWR), U12.2
/CM4_GPIO ( Ethernet, GPIO, SDCARD)/nRPIBOOT: J11.2, Module1.93 (nRPIBOOT)
/CM4_HighSpeed/USB2_N: Module1.103 (USB2_N), U7.4 (D_N)
/CM4_HighSpeed/USB2_P: Module1.105 (USB2_P), U7.3 (D_P)
/CM4_HighSpeed/USBOTG_ID: Module1.101 (USB_OTG_ID), R29.1, R30.2, U7.2 (SEL)
/USB2-HUB/HD1_N: J8.2 (D-`), U8.1 (USBDM_DN1/PRT_DIS_M1)
/USB2-HUB/HD1_P: J8.3 (D+`), U8.2 (USBDP_DN1/PRT_DIS_P1)
/USB2-HUB/HD2_N: J8.6 (D-), U8.3 (USBDM_DN2/PRT_DIS_M2)
/USB2-HUB/HD2_P: J8.7 (D+), U8.4 (USBDP_DN2/PRT_DIS_P2)
/USB2-HUB/HD3_N: J17.2 (D-`), U8.6 (USBDM_DN3/PRT_DIS_M3)
/USB2-HUB/HD3_P: J17.3 (D+`), U8.7 (USBDP_DN3/PRT_DIS_P3)
/USB2-HUB/HD4_N: J17.6 (D-), U8.8 (USBDM_DN4/PRT_DIS_M4)
/USB2-HUB/HD4_P: J17.7 (D+), U8.9 (USBDP_DN4/PRT_DIS_P4)
/USB2-HUB/PWR1: U8.12 (PRTPWR1/BC_EN1), U10.3 (EN)
/USB2-HUB/USBD_N: J7.2 (D-), U7.8 (HSD1_M), U9.4 (D2+), U9.7
/USB2-HUB/USBD_P: J7.3 (D+), U7.9 (HSD1_P), U9.5 (D2-), U9.6
/USB2-HUB/USBH_N: U7.6 (HSD0_M), U8.30 (USBDM_UP)
/USB2-HUB/USBH_P: U7.7 (HSD0_P), U8.31 (USBDP_UP)
/USB2-HUB/VBUS: C16.1, C17.1, C18.1, C19.1, C20.1, J8.1 (VBUS`), J8.5 (VBUS), J17.1 (VBUS`), J17.5 (VBUS), U10.6 (OUT)
/USB2-HUB/nOCS1: U8.13 (OCS_N1), U8.17 (OCS_N2), U8.19 (OCS_N3), U8.21 (OCS_N4), U10.4 (nFault)
/nEXTRST: Module1.100 (nEXTRST), U8.26 (RESET_N)
BATT+: J1.1, R22.1, U13.1, U14.1, U15.1, U16.1
BG: C35.2, J31.3 (2.1), J31.4 (2.2), J31.7 (4.1), J31.8 (4.2), J31.11 (6.1), J31.12 (6.2), J31.15 (8.1), J31.16 (8.2), R56.2, U18.4 (GND)
BV: J31.1 (1.1), J31.2 (1.2), J31.5 (3.1), J31.6 (3.2), J31.9 (5.1), J31.10 (5.2), J31.13 (7.1), J31.14 (7.2), R54.1, R57.2, U17.5 (D), U17.6 (D), U17.7 (D), U17.8 (D), U18.1 (VIN)
CLAMP_C: J16.6, R28.2, U4.J2_61 (PWM_2)
D0 STEPPER ENABLE: Q1.1 (G), U4.J2_62 (PWM_7)
DVR_+5VOUT_1: J6.8, J9.2, J9.4, J10.A11, J10.B11
DVR_+5VOUT_2: J15.8, J18.A11, J18.B11, J21.2, J21.4
DVR_+5VOUT_3: J19.A11, J19.B11, J23.8, J24.2, J24.4
DVR_+5VOUT_4: J20.A11, J20.B11, J26.8, J27.2, J27.4
DVR_+Vmot_1: J5.2, J10.A21, J10.A22, J10.B21, J10.B22
DVR_+Vmot_2: J18.A21, J18.A22, J18.B21, J18.B22, J22.2
DVR_+Vmot_3: J19.A21, J19.A22, J19.B21, J19.B22, J25.2
DVR_+Vmot_4: J20.A21, J20.A22, J20.B21, J20.B22, J28.2
DVR_A-/SIN-/LH1_1: J9.5, J10.A13
DVR_A-/SIN-/LH1_2: J18.B13, J21.5
DVR_A-/SIN-/LH1_3: J19.B13, J24.5
DVR_A-/SIN-/LH1_4: J20.B13, J27.5
DVR_A/A+_1: J6.1, J10.B29, J10.B30, J10.B31, J10.B32
DVR_A/A+_2: J15.1, J18.A29, J18.A30, J18.A31, J18.A32
DVR_A/A+_3: J19.A29, J19.A30, J19.A31, J19.A32, J23.1
DVR_A/A+_4: J20.A29, J20.A30, J20.A31, J20.A32, J26.1
DVR_A/SIN+_1: J9.6, J10.A14
DVR_A/SIN+_2: J18.B14, J21.6
DVR_A/SIN+_3: J19.B14, J24.6
DVR_A/SIN+_4: J20.B14, J27.6
DVR_B-/COS-/LH2_1: J9.7, J10.A15
DVR_B-/COS-/LH2_2: J18.B15, J21.7
DVR_B-/COS-/LH2_3: J19.B15, J24.7
DVR_B-/COS-/LH2_4: J20.B15, J27.7
DVR_BR/B-_1: J6.7, J10.A25, J10.A26, J10.A27, J10.A28
DVR_BR/B-_2: J15.7, J18.B25, J18.B26, J18.B27, J18.B28
DVR_BR/B-_3: J19.B25, J19.B26, J19.B27, J19.B28, J23.7
DVR_BR/B-_4: J20.B25, J20.B26, J20.B27, J20.B28, J26.7
DVR_B/A-_1: J6.6, J10.A29, J10.A30, J10.A31, J10.A32
DVR_B/A-_2: J15.6, J18.B29, J18.B30, J18.B31, J18.B32
DVR_B/A-_3: J19.B29, J19.B30, J19.B31, J19.B32, J23.6
DVR_B/A-_4: J20.B29, J20.B30, J20.B31, J20.B32, J26.6
DVR_B/COS+_1: J9.8, J10.A16
DVR_B/COS+_2: J18.B16, J21.8
DVR_B/COS+_3: J19.B16, J24.8
DVR_B/COS+_4: J20.B16, J27.8
DVR_CAN_Hi_1: IC2.7 (CANH), J10.A19, J18.B19, J19.B19, J20.B19, R53.1
DVR_CAN_Lo_1: IC2.6 (CANL), J10.B19, J18.A19, J19.A19, J20.A19, R53.2
DVR_C/B+_1: J6.2, J10.B25, J10.B26, J10.B27, J10.B28
DVR_C/B+_2: J15.2, J18.A25, J18.A26, J18.A27, J18.A28
DVR_C/B+_3: J19.A25, J19.A26, J19.A27, J19.A28, J23.2
DVR_C/B+_4: J20.A25, J20.A26, J20.A27, J20.A28, J26.2
DVR_HALL1_1: J6.3, J10.A8
DVR_HALL1_2: J15.3, J18.B8
DVR_HALL1_3: J19.B8, J23.3
DVR_HALL1_4: J20.B8, J26.3
DVR_HALL2_1: J6.4, J10.A9
DVR_HALL2_2: J15.4, J18.B9
DVR_HALL2_3: J19.B9, J23.4
DVR_HALL2_4: J20.B9, J26.4
DVR_HALL3_1: J6.5, J10.A10
DVR_HALL3_2: J15.5, J18.B10
DVR_HALL3_3: J19.B10, J23.5
DVR_HALL3_4: J20.B10, J26.5
DVR_Z+_1: J9.10, J10.A18
DVR_Z+_2: J18.B18, J21.10
DVR_Z+_3: J19.B18, J24.10
DVR_Z+_4: J20.B18, J27.10
DVR_Z-/LH3_1: J9.9, J10.A17
DVR_Z-/LH3_2: J18.B17, J21.9
DVR_Z-/LH3_3: J19.B17, J24.9
DVR_Z-/LH3_4: J20.B17, J27.9
ENCODER1_PHASEA: R14.2, R15.1, U4.J2_16 (CAM_D0)
ENCODER1_PHASEA_IN: J16.19, R14.1
ENCODER1_PHASEB: R7.2, R8.1, U4.J2_14 (CAM_D1)
ENCODER1_PHASEB_IN: J16.18, R7.1
ENCODER1_PHASEZ: R1.2, R2.1, U4.J2_12 (CAM_D2)
ENCODER1_PHASEZ_IN: J16.17, R1.1
ENCODER2_PHASEA: R16.2, R17.1, U4.J2_10 (CAM_D3)
ENCODER2_PHASEA_IN: J16.14, R16.1
ENCODER2_PHASEB: R9.2, R10.1, U4.J2_8 (CAM_D4)
ENCODER2_PHASEB_IN: J16.13, R9.1
ENCODER2_PHASEZ: R3.2, R4.1, U4.J2_6 (CAM_D5)
ENCODER2_PHASEZ_IN: J16.12, R3.1
GND: C1.1, C2.1, C3.1, C4.2, C5.2, C6.2, C7.2, C8.2, C9.2, C10.2, C11.2, C12.2, C13.2, C14.2, C15.2, C16.2, C17.2, C18.2, C19.2, C20.2, C21.2, C22.2, C23.2, C24.2, C25.2, C26.2, C27.2, C28.2, C29.2, C30.2, C31.2, C32.2, C33.2, C34.2, D3.A, D4.A, D5.A, D6.A, IC1.8 (GND), IC2.2 (GND), J4.3, J4.6, J4.9, J4.12, J4.15, J4.18, J4.21, J4.24, J5.1, J6.9, J6.10, J7.5 (GND), J7.6 (Shield), J8.4 (GND`), J8.8 (GND), J8.MT1, J8.MT2, J8.MT3, J8.MT4, J9.1, J9.3, J10.A1, J10.A12, J10.A20, J10.A23, J10.A24, J10.B1, J10.B5, J10.B23, J10.B24, J11.1, J11.3, J11.7, J11.10, J11.12, J12.2, J13.2, J14.6, J14.9, J14.14, J14.20, J14.25, J14.30, J14.34, J14.39, J15.9, J15.10, J16.1, J16.11, J16.16, J17.4 (GND`), J17.8 (GND), J17.MT1, J17.MT2, J17.MT3, J17.MT4, J18.A1, J18.A5, J18.A23, J18.A24, J18.B1, J18.B12, J18.B20, J18.B23, J18.B24, J19.A1, J19.A5, J19.A23, J19.A24, J19.B1, J19.B12, J19.B20, J19.B23, J19.B24, J20.A1, J20.A5, J20.A23, J20.A24, J20.B1, J20.B12, J20.B20, J20.B23, J20.B24, J21.1, J21.3, J22.1, J23.9, J23.10, J24.1, J24.3, J25.1, J26.9, J26.10, J27.1, J27.3, J28.1, LED1.1 (K), LED2.1 (K), LED3.1 (K), LED4.1 (K), LED5.1 (K), Module1.1 (GND), Module1.2 (GND), Module1.7 (GND), Module1.8 (GND), Module1.13 (GND), Module1.14 (GND), Module1.22 (GND), Module1.23 (GND), Module1.32 (GND), Module1.33 (GND), Module1.42 (GND), Module1.43 (GND), Module1.52 (GND), Module1.53 (GND), Module1.59 (GND), Module1.60 (GND), Module1.65 (GND), Module1.66 (GND), Module1.71 (GND), Module1.74 (GND), Module1.98 (GND), Module1.107 (GND), Module1.108 (GND), Module1.113 (GND), Module1.114 (GND), Module1.119 (GND), Module1.120 (GND), Module1.125 (GND), Module1.126 (GND), Module1.131 (GND), Module1.132 (GND), Module1.137 (GND), Module1.138 (GND), Module1.144 (GND), Module1.150 (GND), Module1.155 (GND), Module1.156 (GND), Module1.161 (GND), Module1.162 (GND), Module1.167 (GND), Module1.168 (GND), Module1.173 (GND), Module1.174 (GND), Module1.179 (GND), Module1.180 (GND), Module1.185 (GND), Module1.186 (GND), Module1.191 (GND), Module1.192 (GND), Module1.197 (GND), Module1.198 (GND), PS1.3 (-VIN), PS1.4 (-VOUT), PS2.3 (-VIN), PS2.4 (-VOUT), PS3.5 (-VOUT), PS3.6 (ON/OFF_CONTROL), R2.2, R4.2, R8.2, R10.2, R15.2, R17.2, R21.2, R23.2, R27.2, R29.2, R31.2, R32.2, R33.2, R34.2, R35.2, R36.2, R37.2, R40.2, R41.2, R43.2, R46.1, R47.2, R48.2, U1.6 (GND), U1.11 (GND), U1.13 (NC), U2.6 (GND), U2.11 (GND), U2.13 (NC), U3.6 (GND), U3.11 (GND), U3.13 (NC), U4.J1_22 (GND), U4.J1_42 (GND), U4.J2_24 (GND_1), U4.J2_33 (GND_1), U4.J2_44 (GND_1), U4.J2_57 (GND_1), U4.J2_70 (GND_1), U5.14 (VSS), U5.25 (EXTCLK), U6.10 (GND), U7.5 (GND), U7.10 (nOE), U8.37 (VSS), U9.3 (GND), U9.8 (GND), U10.2 (GND), U11.3 (GND), U12.3 (GND)
GPIO4 RED LED: IC1.1 (IN_1), U4.J2_54 (GPIO_4)
GPIO5 YELLOW LED: IC1.2 (IN_2), U4.J2_56 (GPIO_5)
GPIO6 GREEN LED: IC1.3 (IN_3), U4.J2_58 (GPIO_6)
H7_CAN1_RX: IC2.4 (RXD), U4.J1_51 (CAN1_RX)
H7_CAN1_TX: IC2.1 (TXD), U4.J1_49 (CAN1_TX)
H7_I2C0_SCL: R6.2, R18.2, R24.2, R44.2, U1.4 (A1), U1.5 (A0), U1.9 (SCL), U2.4 (A1), U2.9 (SCL), U3.4 (A1), U3.9 (SCL), U4.J1_46 (I2C0_SCL), U5.26 (SCL)
H7_I2C0_SDA: R11.2, R19.2, R25.2, R42.2, U1.8 (SDA), U2.5 (A0), U2.8 (SDA), U3.8 (SDA), U4.J1_44 (I2C0_SDA), U5.27 (SDA)
LED_GREEN: IC1.14 (OUT_5), J16.10
LED_RED: IC1.16 (OUT_7), J16.8
LED_YELLOW: IC1.15 (OUT_6), J16.9
unnamed: C21.1, D3.C, L1.1, U13.2
unnamed: C22.1, D4.C, L2.1, U14.2
unnamed: C23.1, D5.C, L3.1, U15.2
unnamed: C24.1, D6.C, L4.1, U16.2
unnamed: D1.1 (K), R49.1, TP1.1
unnamed: D2.1 (K), R52.1, TP2.1
unnamed: J7.1 (VBUS), R30.1
unnamed: J11.13, U11.4
unnamed: LED1.2 (A), R5.1
unnamed: LED2.2 (A), R12.1
unnamed: LED3.2 (A), R13.1
unnamed: LED4.2 (A), R26.1
unnamed: LED5.2 (A), R45.1
unnamed: Module1.21 (PI_nLED_Activity), R49.2
unnamed: C26.1, L2.2, PS1.1 (+VIN)
unnamed: C27.1, L3.2, PS2.1 (+VIN)
unnamed: C28.1, L4.2, PS3.1 (+VIN)
unnamed: Q1.3 (D), Q2.2 (S)
unnamed: Q1.2 (S), SW1.3
unnamed: R52.2, U12.4
unnamed: U4.J1_31 (GND), U4.J1_47 (GND), U4.J1_54 (GND)
unnamed: U4.J1_53 (VSYS), U4.J1_64 (VSYS)
unnamed: R43.1, U5.23 (*OE)
unnamed: R32.1, U5.1 (A0)
unnamed: R33.1, U5.2 (A1)
unnamed: R34.1, U5.3 (A2)
unnamed: R35.1, U5.4 (A3)
unnamed: R36.1, U5.5 (A4)
unnamed: R37.1, U5.24 (A5)
unnamed: R38.8, U5.6 (LED0)
unnamed: R38.7, U5.7 (LED1)
unnamed: R38.6, U5.8 (LED2)
unnamed: R38.5, U5.9 (LED3)
unnamed: R39.8, U5.10 (LED4)
unnamed: R39.7, U5.11 (LED5)
unnamed: R39.6, U5.12 (LED6)
unnamed: R39.5, U5.13 (LED7)
unnamed: R47.1, U8.25 (HS_IND/CFG_SEL1)
unnamed: R46.2, U8.35 (RBIAS)
unnamed: R31.1, U8.24 (SCL/SMBCLK/CFG_SEL0)
unnamed: R40.1, U8.22 (SDA/SMBDATA/NON_REM1)
unnamed: R41.1, U8.28 (SUSP_IND/LOCAL_PWR/NON_REM0)
unnamed: C5.1, U8.33 (XTALIN/CLKIN), Y1.1
unnamed: C6.1, U8.32 (XTALOUT), Y1.2
unnamed: U9.1 (D1+), U9.10
unnamed: U9.2 (D1-), U9.9
unnamed: R48.1, U10.5 (ILIM)
unnamed: U17.4 (G), U18.8 (GATE), U19.4 (G)
unnamed: U17.1 (S), U17.2 (S), U17.3 (S), U19.1 (S), U19.2 (S), U19.3 (S)
unnamed: R57.1, U18.5 (*SHDN)
unnamed: R55.2, R56.1, U18.3 (OV)
unnamed: R54.2, R55.1, U18.2 (UV)
unnamed: C35.1, J1.2, U18.7 (VOUT), U19.5 (D), U19.6 (D), U19.7 (D), U19.8 (D)
PWM0: J4.2, R38.1
PWM1: J4.5, R38.2
PWM2: J4.8, R38.3
PWM3: J4.11, R38.4
PWM4: J4.14, R39.1
PWM5: J4.17, R39.2
PWM6: J4.20, R39.3
PWM7: J4.23, R39.4
RPI_GPIO_14_TX: J14.8, Module1.55 (GPIO14), U4.J1_36 (UART0_RX)
RPI_GPIO_15_RX: J14.10, Module1.51 (GPIO15), U4.J1_34 (UART0_TX)
STEPPER_ENABLE: R26.2, R27.1, SW1.4
UT_SIGNAL: J16.3, R20.1
ZIGBEE_IO: Q2.1 (G), R45.2, U6.20 (AD0/DIO0)
