jaowens14/GR-LRR-PCB/GR-LRR-CONTROL/GR-LRR-CONTROL.kicad_pcb

## KiCad design GR-LRR-CONTROL/GR-LRR-CONTROL.kicad_pcb (2024-05-09)

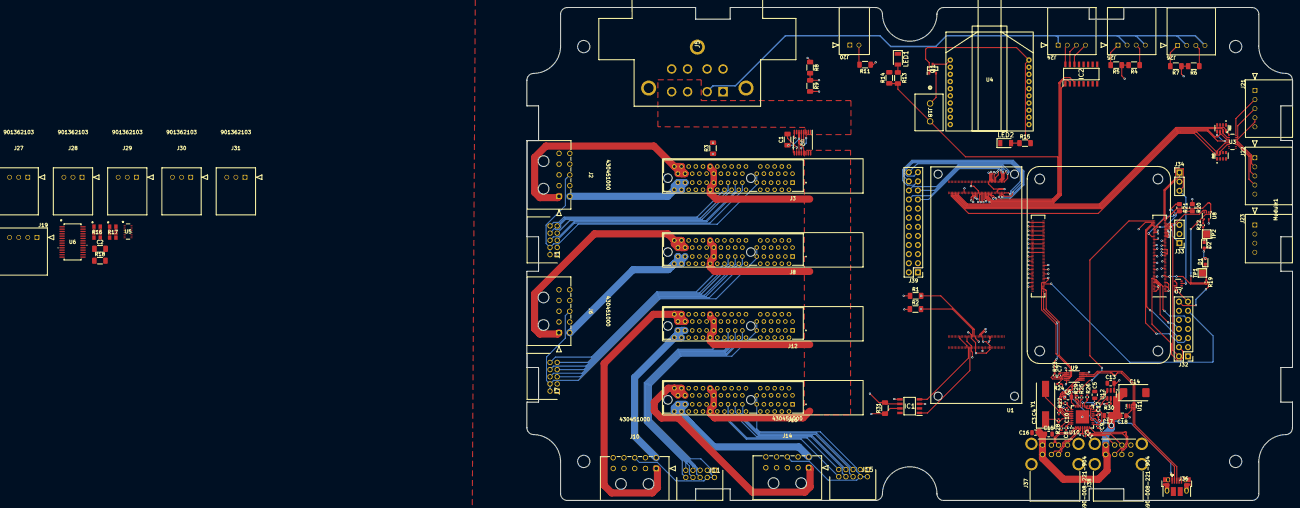
[picture p21: board GR-LRR-CONTROL.kicad_pcb from above]

Board: 4 copper layers, 213.7 x 137.6 mm, 106 parts (0 on the bottom side), 190 nets.

Parts:
C1: 0.1uF; C_1206_3216Metric_Pad1.33x1.80mm_HandSolder
C2: 10uF; C_1206_3216Metric_Pad1.33x1.80mm_HandSolder
C3, C4: 27pF; C_0402_1005Metric
C5, C6, C13, C15, C16, C17, C18: 10u; C_0805_2012Metric
C7, C8, C9, C10, C11, C12: 100n; C_0402_1005Metric
C14: 100uF; CP_EIA-7343-31_Kemet-D
D1: LED Green; LED_0603_1608Metric
D2: LED Red; LED_0603_1608Metric
IC1: TJA1049T,118
IC2: MC1413DR2G; SOIC127P600X175-16N
J1, J7, J11, J15: 87833-1019
J2, J6, J10, J14: 430451000
J3, J8, J12, J16: 10018783-10101TLF; AMPHENOL_10018783-10101TLF
J5: DT13-08PB; DT1308PB
J18: 691137710002
J19, J23: 901362104
J20: 901362102
J21: ENC1; 901362105
J22: ENC2; 901362105
J24: LED; 901362104
J25: UT1; 901362104
J26: UT2; 901362104
J27, J28, J29, J30, J31: 901362103
J32: Conn_02x07_Odd_Even; PinHeader_2x07_P2.54mm_Vertical
J33, J34: Conn_01x03; PinHeader_1x03_P2.54mm_Vertical
J36: USB_OTG; USB_Micro-B_EDAC_UCON00686
J37, J38: 690-008-221-904; MOLEX_USB_67298-4090
J39: Conn_02x12_Counter_Clockwise; PinHeader_2x12_P2.54mm_Vertical
LED1, LED2: QTLP650C2TR; LEDC3216X130N
Module1: ComputeModule4; Raspberry-Pi-4-Compute-Module
Q1: BSS806NH6327XTSA1; SOT95P240X110-3N
R1, R2, R18: 10k; R_1206_3216Metric_Pad1.30x1.75mm_HandSolder
R3, R31: 120; R_1206_3216Metric_Pad1.30x1.75mm_HandSolder
R4, R6: 4k; R_1206_3216Metric_Pad1.30x1.75mm_HandSolder
R5, R7: 1k 1/8w; R_1206_3216Metric_Pad1.30x1.75mm_HandSolder
R8: 100k 1/8W; R_1206_3216Metric_Pad1.30x1.75mm_HandSolder
R9: 10k 1/8w; R_1206_3216Metric_Pad1.30x1.75mm_HandSolder
R10, R12: YC164-JR-072KL; RESCAXE80P320X160X70-8N
R11, R14: 10k 1/8W; R_1206_3216Metric_Pad1.30x1.75mm_HandSolder
R13, R15: 86ohm, 1/10w; R_1206_3216Metric_Pad1.30x1.75mm_HandSolder
R16, R17: CAY16-221J4LF; CAY16_221J4LF
R19, R22: 1k; R_0402_1005Metric
R20: 0R; R_0805_2012Metric_Pad1.20x1.40mm_HandSolder
R21: nf; R_0805_2012Metric_Pad1.20x1.40mm_HandSolder
R23, R24: 2.2K 1%; R_0402_1005Metric
R25, R26, R27, R29: 36K 1%; R_0402_1005Metric
R28: 12K 1%; R_0402_1005Metric
R30: 15K 1%; R_0402_1005Metric
TP1, TP2: TestPoint; TestPoint_Pad_2.0x2.0mm
U1: ABX00042; MODULE_ABX00042_2
U2: INA260AIPWR; PW0016A_N
U3: 1k; RES_YC248_4X1P6_YAG
U4: XB3-24AST-J
U5: YC248-JR-0710KL; RES_YC248_4X1P6_YAG
U6: PCA9685PW; SOT361-1_NXP
U7, U8: 74LVC1G07SE-7; SOT-353_SC-70-5
U9: FSUSB42MUX; MSOP-10_3x3mm_P0.5mm
U10: USB2514B-I/M2; QFN-36-1EP_6x6mm_P0.5mm_EP3.7x3.7mm
U11: TPD4EUSB30; USON-10_2.5x1.0mm_P0.5mm
U12: AP22653W6; SOT-23-6
Y1: 24MHz; Crystal_SMD_HC49-SD

Connections:
3.3V: C1.2, C5.1, C6.1, C7.1, C8.1, C9.1, C10.1, C11.1, C12.1, D1.2 (A), D2.2 (A), IC1.5 (SPLIT), J5.6, Module1.84 (+3.3v_(Output)), Module1.86 (+3.3v_(Output)), Q1.3 (D), R11.1, R20.1, U2.10 (VS), U4.1 (VCC), U8.5 (VCC), U9.1 (VCC), U10.5 (VDDA33), U10.10 (VDDA33), U10.15 (VDD33), U10.23 (VDD33), U10.27 (VBUS_DET), U10.29 (VDDA33), U10.36 (VDDA33)
5V: C2.1, C13.1, IC1.3 (VCC), J5.7, J19.1, J21.1, J22.1, J23.1, J27.2, J28.2, J29.2, J30.2, J31.2, Module1.77 (+5v_(Input)), Module1.79 (+5v_(Input)), Module1.81 (+5v_(Input)), Module1.83 (+5v_(Input)), Module1.85 (+5v_(Input)), Module1.87 (+5v_(Input)), R1.1, R2.1, U1.J1_21 (VIN), U1.J1_32 (VIN), U1.J1_41 (VIN), U1.J1_48 (VIN), U6.28 (VDD), U7.5 (VCC), U12.1 (IN)
18V: J3.A21, J3.A22, J3.B21, J3.B22, J8.A21, J8.A22, J8.B21, J8.B22, J12.A21, J12.A22, J12.B21, J12.B22, J16.A21, J16.A22, J16.B21, J16.B22, U2.14 (IN-), U2.15 (IN-), U2.16 (IN-)
18V_IN: J5.3, J5.4, U2.1 (IN+), U2.2 (IN+), U2.3 (IN+), U2.12 (VBUS)
24V: J5.2, J24.1, J25.2, J25.4, J26.2, J26.4
/CM4_GPIO ( Ethernet, GPIO, SDCARD)/+1.8v: Module1.88 (+1.8v_(Output)), Module1.90 (+1.8v_(Output)), R21.1
/CM4_GPIO ( Ethernet, GPIO, SDCARD)/AIN0: J32.5, Module1.96 (AnalogIP0)
/CM4_GPIO ( Ethernet, GPIO, SDCARD)/AIN1: J32.6, Module1.94 (AnalogIP1)
/CM4_GPIO ( Ethernet, GPIO, SDCARD)/BT_nDis: J33.3, Module1.91 (BT_nDisable)
/CM4_GPIO ( Ethernet, GPIO, SDCARD)/EEPROM_nWP: J32.4, Module1.20 (EEPROM_nWP)
/CM4_GPIO ( Ethernet, GPIO, SDCARD)/GLOBAL_EN: J32.14, J34.1, Module1.99 (Global_EN)
/CM4_GPIO ( Ethernet, GPIO, SDCARD)/GPIO_VREF: Module1.78 (GPIO_VREF(1.8v/3.3v_Input)), R20.2, R21.2
/CM4_GPIO ( Ethernet, GPIO, SDCARD)/RUN_PG: J34.3, Module1.92 (RUN_PG), U7.2
/CM4_GPIO ( Ethernet, GPIO, SDCARD)/SYNC_IN: J32.8, Module1.16 (Ethernet_SYNC_IN(1.8v))
/CM4_GPIO ( Ethernet, GPIO, SDCARD)/SYNC_OUT: J32.9, Module1.18 (Ethernet_SYNC_OUT(1.8v))
/CM4_GPIO ( Ethernet, GPIO, SDCARD)/TV_OUT: J32.11, Module1.111 (VDAC_COMP)
/CM4_GPIO ( Ethernet, GPIO, SDCARD)/WL_nDis: J33.1, Module1.89 (WL_nDisable)
/CM4_GPIO ( Ethernet, GPIO, SDCARD)/nPWR_LED: Module1.95 (nPI_LED_PWR), U8.2
/CM4_GPIO ( Ethernet, GPIO, SDCARD)/nRPIBOOT: J32.2, Module1.93 (nRPIBOOT)
/CM4_HighSpeed/USB2_N: Module1.103 (USB2_N), U9.4 (D_N)
/CM4_HighSpeed/USB2_P: Module1.105 (USB2_P), U9.3 (D_P)
/CM4_HighSpeed/USBOTG_ID: Module1.101 (USB_OTG_ID), R23.1, R24.2, U9.2 (SEL)
/USB2-HUB/HD1_N: J37.2 (D-`), U10.1 (USBDM_DN1/PRT_DIS_M1)
/USB2-HUB/HD1_P: J37.3 (D+`), U10.2 (USBDP_DN1/PRT_DIS_P1)
/USB2-HUB/HD2_N: J37.6 (D-), U10.3 (USBDM_DN2/PRT_DIS_M2)
/USB2-HUB/HD2_P: J37.7 (D+), U10.4 (USBDP_DN2/PRT_DIS_P2)
/USB2-HUB/HD3_N: J38.2 (D-`), U10.6 (USBDM_DN3/PRT_DIS_M3)
/USB2-HUB/HD3_P: J38.3 (D+`), U10.7 (USBDP_DN3/PRT_DIS_P3)
/USB2-HUB/HD4_N: J38.6 (D-), U10.8 (USBDM_DN4/PRT_DIS_M4)
/USB2-HUB/HD4_P: J38.7 (D+), U10.9 (USBDP_DN4/PRT_DIS_P4)
/USB2-HUB/PWR1: U10.12 (PRTPWR1/BC_EN1), U12.3 (EN)
/USB2-HUB/USBD_N: J36.2 (D-), U9.8 (HSD1_M), U11.4 (D2+), U11.7
/USB2-HUB/USBD_P: J36.3 (D+), U9.9 (HSD1_P), U11.5 (D2-), U11.6
/USB2-HUB/USBH_N: U9.6 (HSD0_M), U10.30 (USBDM_UP)
/USB2-HUB/USBH_P: U9.7 (HSD0_P), U10.31 (USBDP_UP)
/USB2-HUB/VBUS: C14.1, C15.1, C16.1, C17.1, C18.1, J37.1 (VBUS`), J37.5 (VBUS), J38.1 (VBUS`), J38.5 (VBUS), U12.6 (OUT)
/USB2-HUB/nOCS1: U10.13 (OCS_N1), U10.17 (OCS_N2), U10.19 (OCS_N3), U10.21 (OCS_N4), U12.4 (nFault)
/nEXTRST: Module1.100 (nEXTRST), U10.26 (RESET_N)
A3: J39.20, U1.J2_79 (ADC_A3)
A4: J39.21, U1.J2_74 (ADC_A4)
A5: J39.22, U1.J2_76 (ADC_A5)
A6: J39.23, U1.J2_78 (ADC_A6)
A7: J39.24, U1.J2_80 (ADC_A7)
BATT+: J5.5, R8.1
BAT_MON_73_A0: J39.17, R8.2, R9.1, U1.J2_73 (ADC_A0)
CLAMP_C: J20.2, R11.2
D0 ESTOP DETECT: J18.2, J39.10, R13.2, R14.1, U1.J2_62 (PWM_7)
D1: J39.11, U1.J2_60 (PWM_6)
D2: J39.12, U1.J2_67 (PWM_5)
D3: J39.13, U1.J2_65 (PWM_4)
D4: J39.14, U1.J2_63 (PWM_3)
D5 Clamp: J39.15, U1.J2_61 (PWM_2)
D6: J39.16, U1.J2_59 (PWM_1)
D7 CS: J39.9, U1.J2_36 (SPI1_CS)
D8 COPI: J39.6, U1.J2_42 (SPI1_MOSI)
D9 CK: J39.8, U1.J2_38 (SPI1_CK)
D10 CIPO: J39.7, U1.J2_40 (SPI1_MISO)
DVR_+5VOUT_1: J1.2, J1.4, J2.8, J3.A11, J3.B11
DVR_+5VOUT_2: J6.8, J7.2, J7.4, J8.A11, J8.B11
DVR_+5VOUT_3: J10.8, J11.2, J11.4, J12.A11, J12.B11
DVR_+5VOUT_4: J14.8, J15.2, J15.4, J16.A11, J16.B11
DVR_A-/SIN-/LH1_1: J1.5, J3.A13
DVR_A-/SIN-/LH1_2: J7.5, J8.A13
DVR_A-/SIN-/LH1_3: J11.5, J12.A13
DVR_A-/SIN-/LH1_4: J15.5, J16.A13
DVR_A/A+_1: J2.1, J3.B29, J3.B30, J3.B31, J3.B32
DVR_A/A+_2: J6.1, J8.B29, J8.B30, J8.B31, J8.B32
DVR_A/A+_3: J10.1, J12.B29, J12.B30, J12.B31, J12.B32
DVR_A/A+_4: J14.1, J16.B29, J16.B30, J16.B31, J16.B32
DVR_A/SIN+_1: J1.6, J3.A14
DVR_A/SIN+_2: J7.6, J8.A14
DVR_A/SIN+_3: J11.6, J12.A14
DVR_A/SIN+_4: J15.6, J16.A14
DVR_B-/COS-/LH2_1: J1.7, J3.A15
DVR_B-/COS-/LH2_2: J7.7, J8.A15
DVR_B-/COS-/LH2_3: J11.7, J12.A15
DVR_B-/COS-/LH2_4: J15.7, J16.A15
DVR_BR/B-_1: J2.7, J3.A25, J3.A26, J3.A27, J3.A28
DVR_BR/B-_2: J6.7, J8.A25, J8.A26, J8.A27, J8.A28
DVR_BR/B-_3: J10.7, J12.A25, J12.A26, J12.A27, J12.A28
DVR_BR/B-_4: J14.7, J16.A25, J16.A26, J16.A27, J16.A28
DVR_B/A-_1: J2.6, J3.A29, J3.A30, J3.A31, J3.A32
DVR_B/A-_2: J6.6, J8.A29, J8.A30, J8.A31, J8.A32
DVR_B/A-_3: J10.6, J12.A29, J12.A30, J12.A31, J12.A32
DVR_B/A-_4: J14.6, J16.A29, J16.A30, J16.A31, J16.A32
DVR_B/COS+_1: J1.8, J3.A16
DVR_B/COS+_2: J7.8, J8.A16
DVR_B/COS+_3: J11.8, J12.A16
DVR_B/COS+_4: J15.8, J16.A16
DVR_CAN_1_+: IC1.7 (CANH), J3.A19, J8.A19, J12.A19, J16.A19, R3.1, R31.1
DVR_CAN_1_-: IC1.6 (CANL), J3.B19, J8.B19, J12.B19, J16.B19, R3.2, R31.2
DVR_C/B+_1: J2.2, J3.B25, J3.B26, J3.B27, J3.B28
DVR_C/B+_2: J6.2, J8.B25, J8.B26, J8.B27, J8.B28
DVR_C/B+_3: J10.2, J12.B25, J12.B26, J12.B27, J12.B28
DVR_C/B+_4: J14.2, J16.B25, J16.B26, J16.B27, J16.B28
DVR_HALL1_1: J2.3, J3.A8
DVR_HALL1_2: J6.3, J8.A8
DVR_HALL1_3: J10.3, J12.A8
DVR_HALL1_4: J14.3, J16.A8
DVR_HALL2_1: J2.4, J3.A9
DVR_HALL2_2: J6.4, J8.A9
DVR_HALL2_3: J10.4, J12.A9
DVR_HALL2_4: J14.4, J16.A9
DVR_HALL3_1: J2.5, J3.A10
DVR_HALL3_2: J6.5, J8.A10
DVR_HALL3_3: J10.5, J12.A10
DVR_HALL3_4: J14.5, J16.A10
DVR_Z+_1: J1.10, J3.A18
DVR_Z+_2: J7.10, J8.A18
DVR_Z+_3: J11.10, J12.A18
DVR_Z+_4: J15.10, J16.A18
DVR_Z-/LH3_1: J1.9, J3.A17
DVR_Z-/LH3_2: J7.9, J8.A17
DVR_Z-/LH3_3: J11.9, J12.A17
DVR_Z-/LH3_4: J15.9, J16.A17
ENCODER1_PHASEA: R12.8, U1.J2_16 (CAM_D0), U3.1
ENCODER1_PHASEA_IN: J21.2, U3.16
ENCODER1_PHASEB: R12.7, U1.J2_14 (CAM_D1), U3.2
ENCODER1_PHASEB_IN: J21.3, U3.15
ENCODER1_PHASEZ: R12.6, U1.J2_12 (CAM_D2), U3.3
ENCODER1_PHASEZ_IN: J21.4, U3.14
ENCODER2_PHASEA: R12.5, U1.J2_10 (CAM_D3), U3.4
ENCODER2_PHASEA_IN: J22.2, U3.13
ENCODER2_PHASEB: R10.8, U1.J2_8 (CAM_D4), U3.5
ENCODER2_PHASEB_IN: J22.3, U3.12
ENCODER2_PHASEZ: R10.7, U1.J2_6 (CAM_D5), U3.6
ENCODER2_PHASEZ_IN: J22.4, U3.11
GND: C1.1, C2.2, C3.2, C4.2, C5.2, C6.2, C7.2, C8.2, C9.2, C10.2, C11.2, C12.2, C13.2, C14.2, C15.2, C16.2, C17.2, C18.2, IC1.2 (GND), IC2.8 (GND), J1.1, J1.3, J2.9, J2.10, J3.A1, J3.A12, J3.A20, J3.A23, J3.A24, J3.B1, J3.B5, J3.B23, J3.B24, J5.1, J5.8, J6.9, J6.10, J7.1, J7.3, J8.A1, J8.A12, J8.A20, J8.A23, J8.A24, J8.B1, J8.B5, J8.B23, J8.B24, J10.9, J10.10, J11.1, J11.3, J12.A1, J12.A12, J12.A20, J12.A23, J12.A24, J12.B1, J12.B5, J12.B23, J12.B24, J14.9, J14.10, J15.1, J15.3, J16.A1, J16.A12, J16.A20, J16.A23, J16.A24, J16.B1, J16.B5, J16.B23, J16.B24, J19.4, J21.5, J22.5, J23.4, J25.1, J26.1, J27.3, J28.3, J29.3, J30.3, J31.3, J32.1, J32.3, J32.7, J32.10, J32.12, J33.2, J34.2, J36.5 (GND), J36.6 (Shield), J37.4 (GND`), J37.8 (GND), J37.MT1, J37.MT2, J37.MT3, J37.MT4, J38.4 (GND`), J38.8 (GND), J38.MT1, J38.MT2, J38.MT3, J38.MT4, LED1.1 (K), LED2.1 (K), Module1.1 (GND), Module1.2 (GND), Module1.7 (GND), Module1.8 (GND), Module1.13 (GND), Module1.14 (GND), Module1.22 (GND), Module1.23 (GND), Module1.32 (GND), Module1.33 (GND), Module1.42 (GND), Module1.43 (GND), Module1.52 (GND), Module1.53 (GND), Module1.59 (GND), Module1.60 (GND), Module1.65 (GND), Module1.66 (GND), Module1.71 (GND), Module1.74 (GND), Module1.98 (GND), Module1.107 (GND), Module1.108 (GND), Module1.113 (GND), Module1.114 (GND), Module1.119 (GND), Module1.120 (GND), Module1.125 (GND), Module1.126 (GND), Module1.131 (GND), Module1.132 (GND), Module1.137 (GND), Module1.138 (GND), Module1.144 (GND), Module1.150 (GND), Module1.155 (GND), Module1.156 (GND), Module1.161 (GND), Module1.162 (GND), Module1.167 (GND), Module1.168 (GND), Module1.173 (GND), Module1.174 (GND), Module1.179 (GND), Module1.180 (GND), Module1.185 (GND), Module1.186 (GND), Module1.191 (GND), Module1.192 (GND), Module1.197 (GND), Module1.198 (GND), R5.2, R7.2, R9.2, R10.1, R10.2, R10.3, R10.4, R12.1, R12.2, R12.3, R12.4, R14.2, R18.2, R23.2, R25.2, R26.2, R27.2, R28.1, R29.2, R30.2, U1.J1_22 (GND), U1.J1_42 (GND), U1.J2_24 (GND_1), U1.J2_33 (GND_1), U1.J2_44 (GND_1), U1.J2_57 (GND_1), U1.J2_70 (GND_1), U2.6 (GND), U2.11 (GND), U2.13 (NC), U4.10 (GND), U5.3, U5.4, U5.5, U5.6, U5.7, U5.8, U6.14 (VSS), U6.25 (EXTCLK), U7.3 (GND), U8.3 (GND), U9.5 (GND), U9.10 (nOE), U10.37 (VSS), U11.3 (GND), U11.8 (GND), U12.2 (GND)
GPIO0: J39.5, U1.J2_46 (GPIO_0)
GPIO1: J39.4, U1.J2_48 (GPIO_1)
GPIO2: J39.3, U1.J2_50 (GPIO_2)
GPIO3: J39.2, U1.J2_52 (GPIO_3)
GPIO4 RED LED: IC2.1 (IN_1), J39.1, U1.J2_54 (GPIO_4)
GPIO5 YELLOW LED: IC2.2 (IN_2), U1.J2_56 (GPIO_5)
GPIO6 GREEN LED: IC2.3 (IN_3), U1.J2_58 (GPIO_6)
H7_CAN1_RX: IC1.4 (RXD), U1.J1_51 (CAN1_RX)
H7_CAN1_TX: IC1.1 (TXD), U1.J1_49 (CAN1_TX)
H7_I2C0_SCL: J19.3, J23.3, R2.2, U1.J1_46 (I2C0_SCL), U2.4 (A1), U2.5 (A0), U2.9 (SCL), U6.26 (SCL)
H7_I2C0_SDA: J19.2, J23.2, R1.2, U1.J1_44 (I2C0_SDA), U2.8 (SDA), U6.27 (SDA)
LED_GREEN: IC2.14 (OUT_5), J24.4
LED_RED: IC2.16 (OUT_7), J24.2
LED_YELLOW: IC2.15 (OUT_6), J24.3
unnamed: D1.1 (K), R19.1, TP1.1
unnamed: D2.1 (K), R22.1, TP2.1
unnamed: J32.13, U7.4
unnamed: J36.1 (VBUS), R24.1
unnamed: LED1.2 (A), R13.1
unnamed: LED2.2 (A), R15.1
unnamed: Module1.21 (PI_nLED_Activity), R19.2
unnamed: J18.1, Q1.2 (S)
unnamed: R22.2, U8.4
unnamed: U1.J1_31 (GND), U1.J1_47 (GND), U1.J1_54 (GND)
unnamed: U1.J1_53 (VSYS), U1.J1_64 (VSYS)
unnamed: R18.1, U6.23 (*OE)
unnamed: U5.14, U6.1 (A0)
unnamed: U5.13, U6.2 (A1)
unnamed: U5.12, U6.3 (A2)
unnamed: U5.11, U6.4 (A3)
unnamed: U5.10, U6.5 (A4)
unnamed: U5.9, U6.24 (A5)
unnamed: R16.8, U6.6 (LED0)
unnamed: R16.7, U6.7 (LED1)
unnamed: R16.6, U6.8 (LED2)
unnamed: R16.5, U6.9 (LED3)
unnamed: R17.8, U6.10 (LED4)
unnamed: R17.7, U6.11 (LED5)
unnamed: R17.6, U6.12 (LED6)
unnamed: R17.5, U6.13 (LED7)
unnamed: R29.1, U10.25 (HS_IND/CFG_SEL1)
unnamed: R28.2, U10.35 (RBIAS)
unnamed: R25.1, U10.24 (SCL/SMBCLK/CFG_SEL0)
unnamed: R26.1, U10.22 (SDA/SMBDATA/NON_REM1)
unnamed: R27.1, U10.28 (SUSP_IND/LOCAL_PWR/NON_REM0)
unnamed: C3.1, U10.33 (XTALIN/CLKIN), Y1.1
unnamed: C4.1, U10.32 (XTALOUT), Y1.2
unnamed: U11.1 (D1+), U11.10
unnamed: U11.2 (D1-), U11.9
unnamed: R30.1, U12.5 (ILIM)
PWM0: J27.1, R16.1
PWM1: J28.1, R16.2
PWM2: J29.1, R16.3
PWM3: J30.1, R16.4
PWM4: J31.1, R17.1
RPI_GPIO_14_TX: Module1.55 (GPIO14), U1.J1_36 (UART0_RX)
RPI_GPIO_15_RX: Module1.51 (GPIO15), U1.J1_34 (UART0_TX)
UT1_75_A1: J39.18, R4.2, R5.1, U1.J2_75 (ADC_A1)
UT1_SIGNAL: J25.3, R4.1
UT2_77_A2: J39.19, R6.2, R7.1, U1.J2_77 (ADC_A2)
UT2_SIGNAL: J26.3, R6.1
ZIGBEE_IO: Q1.1 (G), R15.2, U4.20 (AD0/DIO0)
