jaowens14/GR-LRR-PCB/OLD REVS/GR-LRR-POWER-PCB-HIGH-VOLTAGE/GR-LRR-POWER-PCB-HIGH-VOLTAGE.kicad_pcb

## KiCad design OLD REVS/GR-LRR-POWER-PCB-HIGH-VOLTAGE/GR-LRR-POWER-PCB-HIGH-VOLTAGE.kicad_pcb (2024-05-06, an earlier design)

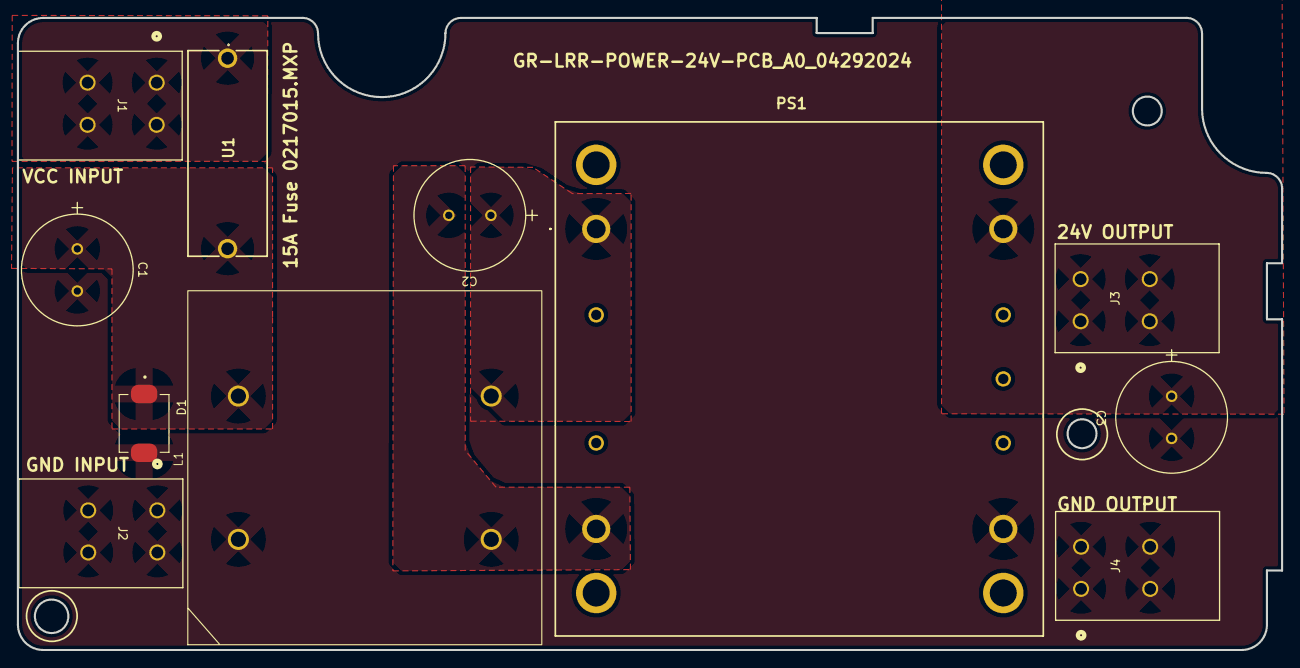
[picture p22: board GR-LRR-POWER-PCB-HIGH-VOLTAGE.kicad_pcb from above]

Board: 2 copper layers, 150.0 x 75.0 mm, 11 parts (0 on the bottom side), 6 nets, no tracks yet.

Parts:
C1, C2, C3: 100PX220MEFC12.5X20; CAP_PK&slash_PZ_12P5X20_LOW_RUB
D1: SMCJ40A; DIOM7959X262N
J1: BATT+; 2604
J2, J4: GND; 2604
J3: 24V; 2604
L1: SC-14-15JH
PS1: QSB30024S24
U1: 696108003002; WR-FSH_THT_2

Connections:
+24V: C3.1, J3.1_1, J3.1_2, J3.2_1, J3.2_2, PS1.9 (+VOUT)
BATT+: C1.1, D1.C, L1.2 (1N2), U1.2
GND: C1.2, C3.2, D1.A, J2.1_1, J2.1_2, J2.2_1, J2.2_2, J4.1_1, J4.1_2, J4.2_1, J4.2_2, L1.1 (1N1), PS1.5 (-VOUT)
unnamed: J1.1_1, J1.1_2, J1.2_1, J1.2_2, U1.1
unnamed: C2.2, L1.4 (2N1), PS1.4 (-VIN)
unnamed: C2.1, L1.3 (2N2), PS1.1 (+VIN)
