jaowens14/GR-LRR-PCB/OLD REVS/GR-LRR-POWER-PCB-INPUT/GR-LRR-POWER-PCB-INPUT.kicad_pcb

## KiCad design OLD REVS/GR-LRR-POWER-PCB-INPUT/GR-LRR-POWER-PCB-INPUT.kicad_pcb (2024-05-06, an earlier design)

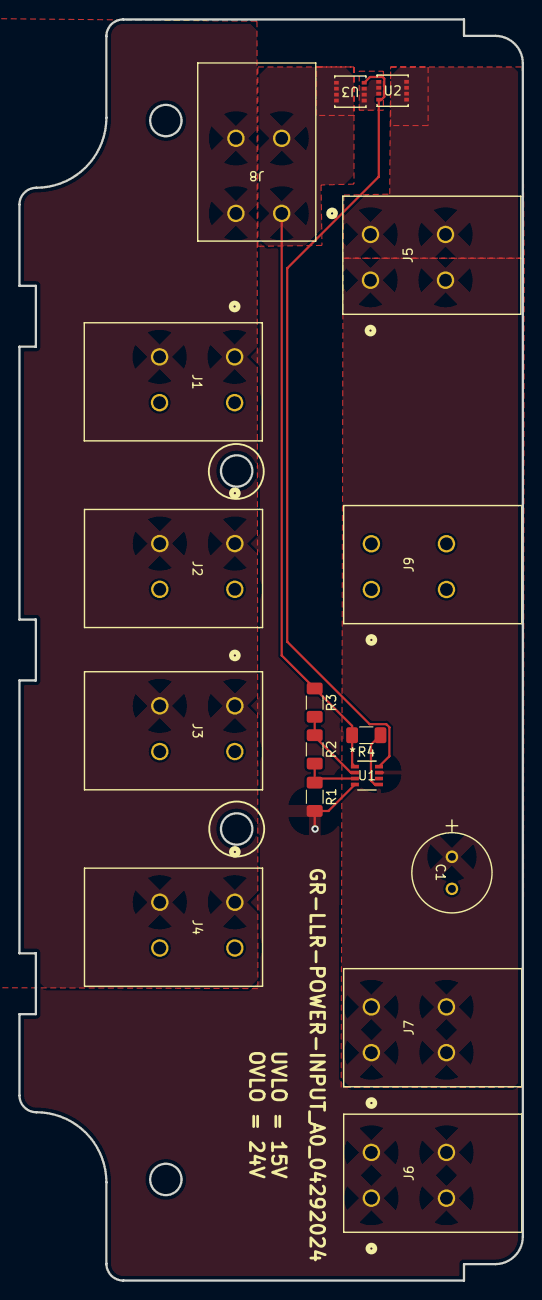
[picture p23: board GR-LRR-POWER-PCB-INPUT.kicad_pcb from above]

Board: 2 copper layers, 55.0 x 137.8 mm, 17 parts (0 on the bottom side), 9 nets.

Parts:
C1: 50ZLH100MEFC8X11.5; CAP_YX_8X11P5_RUB
J1: BATT1; 2604
J2: BATT2; 2604
J3: BATT3; 2604
J4: BATT4; 2604
J5, J7: BATT+; 2604
J6, J9: -BUS; 2604
J8: SWITCH; 2604
R1: 187k; R_1206_3216Metric_Pad1.30x1.75mm_HandSolder
R2: 113k; R_1206_3216Metric_Pad1.30x1.75mm_HandSolder
R3: 8700k; R_1206_3216Metric_Pad1.30x1.75mm_HandSolder
R4: 100k; R_1206_3216Metric_Pad1.30x1.75mm_HandSolder
U1: LTC4365CTS8-TRMPBF; TSOT-23_TS8_LIT
U2, U3: SIS434DN-T1-GE3; MOSFET_4DN-T1-E3_VIS

Connections:
BG: C1.2, J1.2_1, J1.2_2, J2.2_1, J2.2_2, J3.2_1, J3.2_2, J4.2_1, J4.2_2, J6.1_1, J6.1_2, J6.2_1, J6.2_2, J9.1_1, J9.1_2, J9.2_1, J9.2_2, R1.2, U1.4 (GND)
BV: J8.1_1, J8.1_2, R3.1, R4.2, U1.1 (VIN), U3.5 (D), U3.6 (D), U3.7 (D), U3.8 (D)
BV1: J1.1_1, J1.1_2, J2.1_1, J2.1_2, J3.1_1, J3.1_2, J4.1_1, J4.1_2, J8.2_1, J8.2_2
BV_OUT: C1.1, J5.1_1, J5.1_2, J5.2_1, J5.2_2, J7.1_1, J7.1_2, J7.2_1, J7.2_2, U1.7 (VOUT), U2.5 (D), U2.6 (D), U2.7 (D), U2.8 (D)
unnamed: R4.1, U1.5 (*SHDN)
unnamed: U1.8 (GATE), U2.4 (G), U3.4 (G)
unnamed: R1.1, R2.2, U1.3 (OV)
unnamed: R2.1, R3.2, U1.2 (UV)
unnamed: U2.1 (S), U2.2 (S), U2.3 (S), U3.1 (S), U3.2 (S), U3.3 (S)
