jaowens14/GR-LRR-PCB/GR-LRR-PCB_A1/GR-LRR-PCB.kicad_pcb

## KiCad design OLD REVS/GR-LRR-PCB_A1/GR-LRR-PCB.kicad_pcb (2023-12-06, an earlier design)

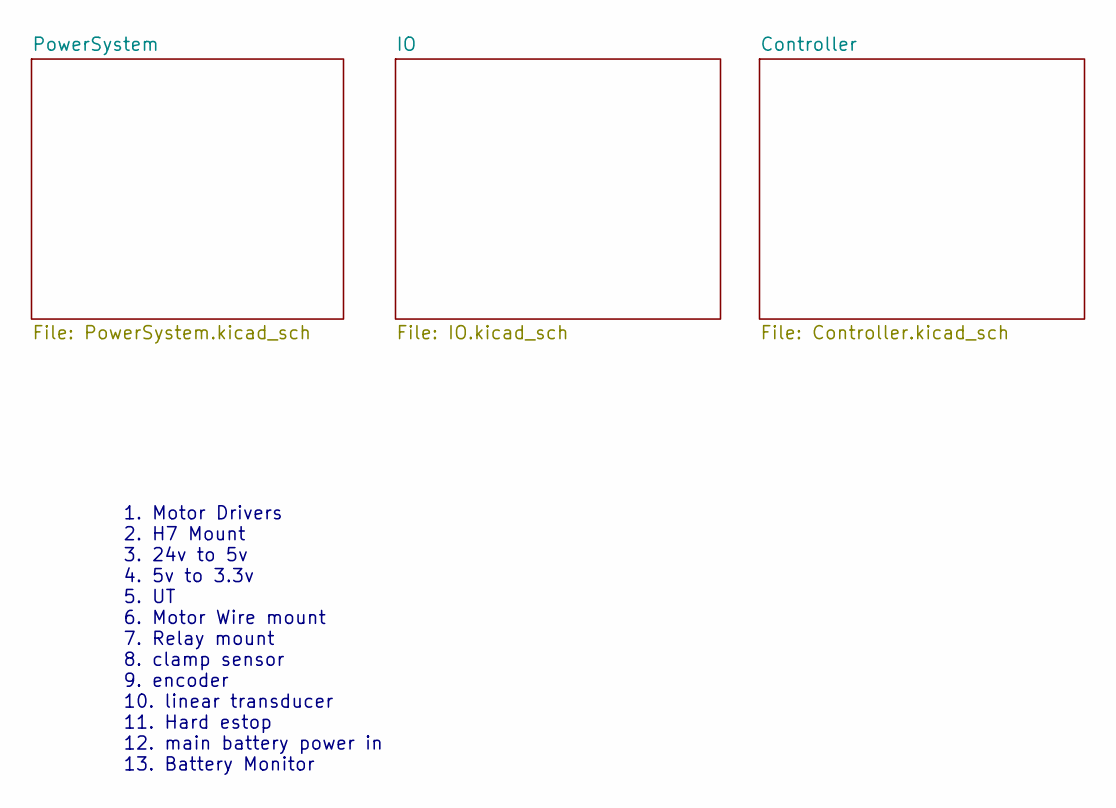
[picture p24: schematic GR-LRR-PCB.kicad_sch]

Notes on the sheet:
1. Motor Drivers 2. H7 Mount 3. 24v to 5v 4. 5v to 3.3v 5. UT 6. Motor Wire mount 7. Relay mount 8. clamp sensor 9. encoder 10. linear transducer 11. Hard estop 12. main battery power in 13. Battery Monitor

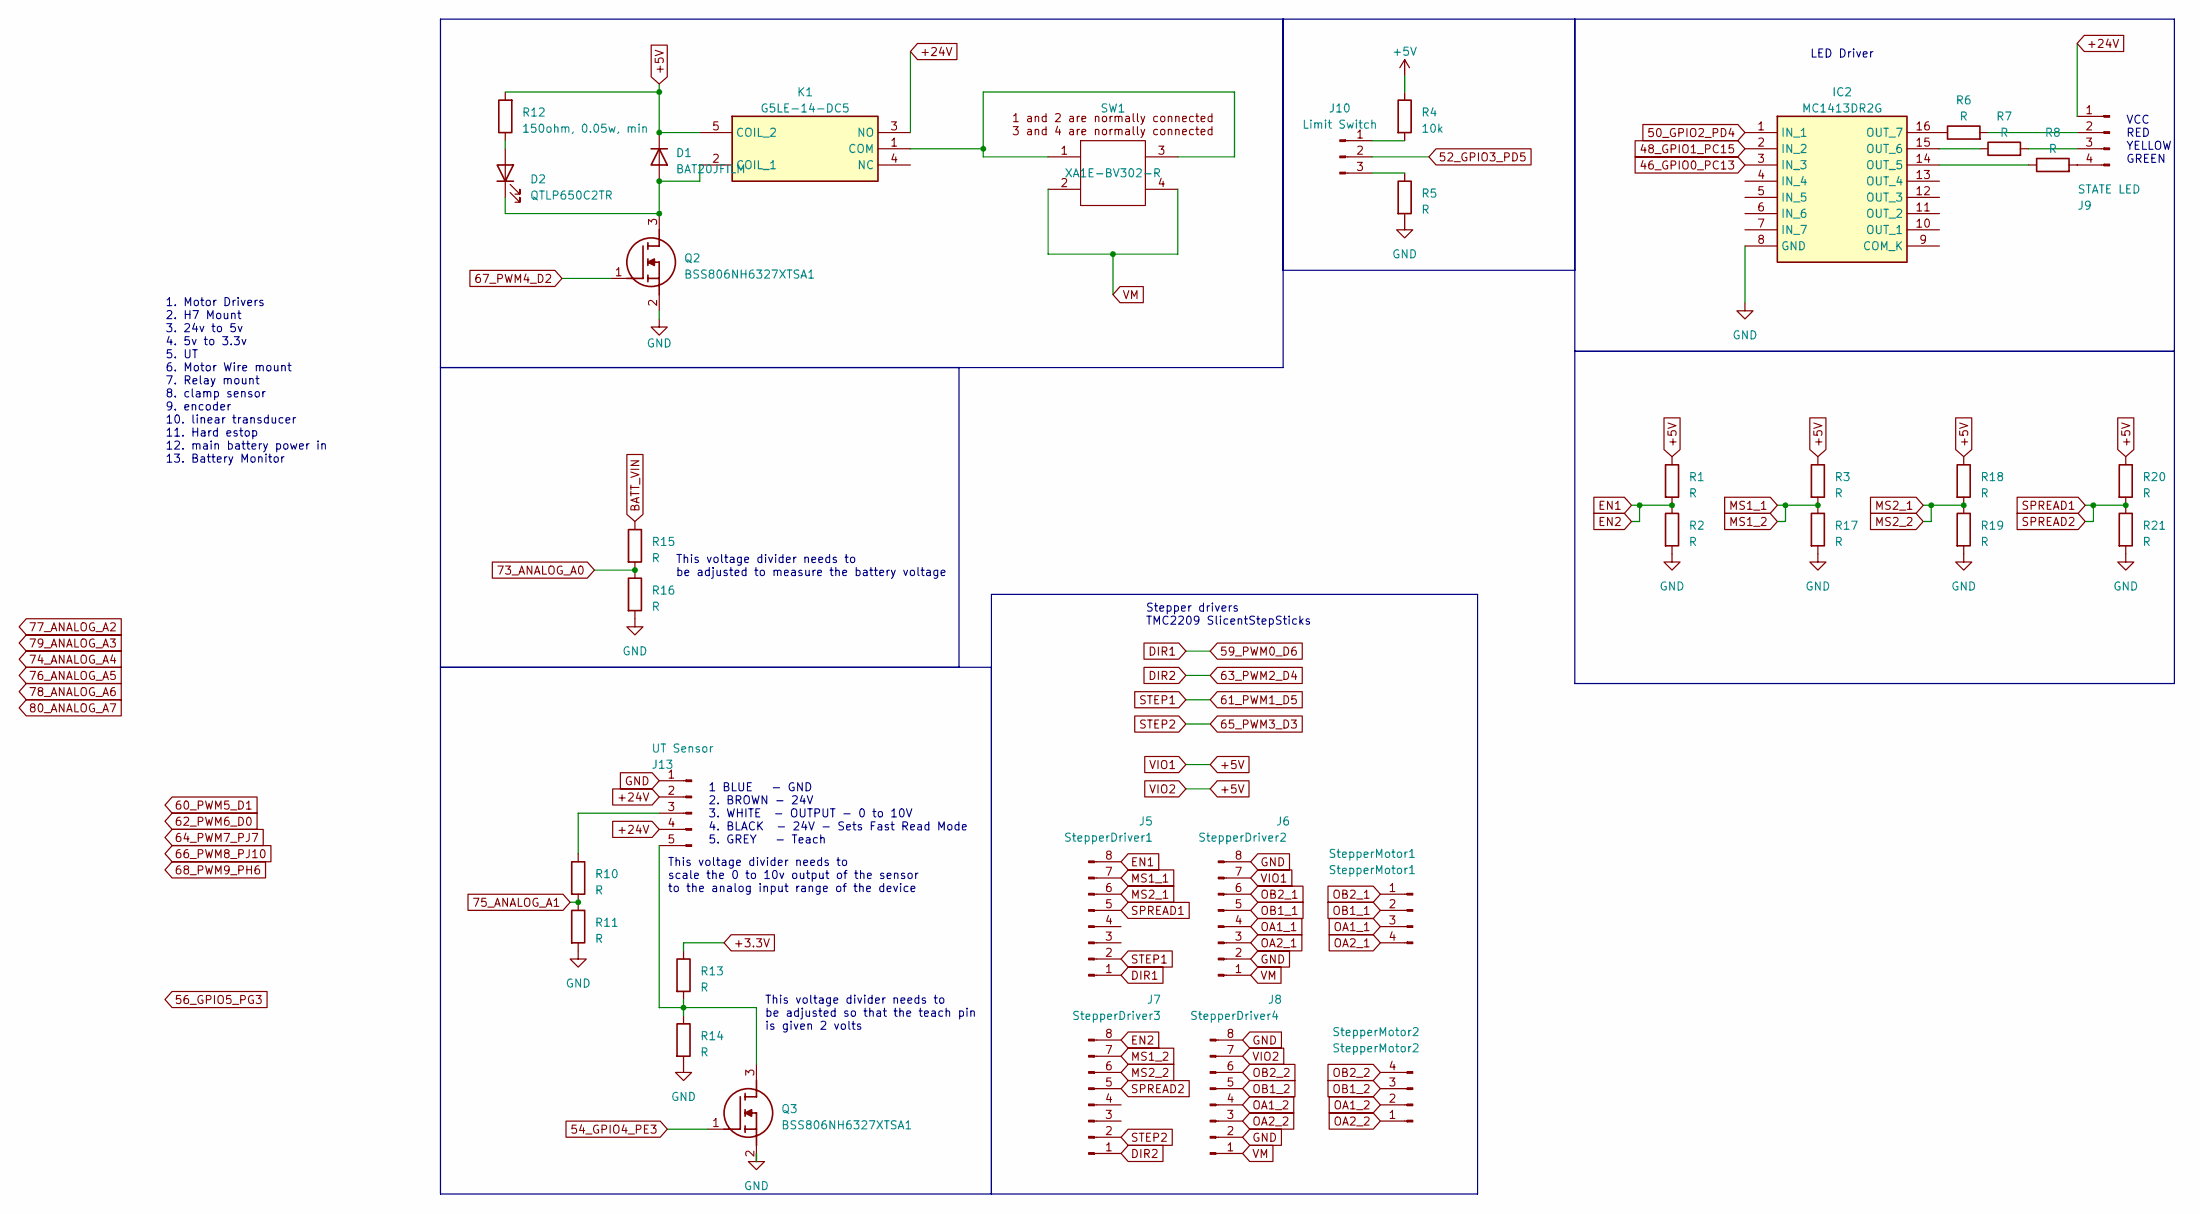
[picture p25: schematic IO.kicad_sch]

Parts:
D1: BAT20JFILM; D_SOD-323_HandSoldering
D2: QTLP650C2TR; D_1206_3216Metric_Pad1.42x1.75mm_HandSolder
IC2: MC1413DR2G; SOIC127P600X175-16N; Mouser Part Number 863-MC1413DR2G
J5: StepperDriver1; PinHeader_1x08_P2.54mm_Vertical
J6: StepperDriver2; PinHeader_1x08_P2.54mm_Vertical
J7: StepperDriver3; PinHeader_1x08_P2.54mm_Vertical
J8: StepperDriver4; PinHeader_1x08_P2.54mm_Vertical
J9: STATE LED; PinHeader_1x04_P2.54mm_Vertical; Part Number JR28-RYG-D
J10: Limit Switch; PinHeader_1x03_P2.54mm_Vertical
J13: UT Sensor; PinHeader_1x05_P2.54mm_Vertical
K1: G5LE-14-DC5; G5LE-14_SPDT; Mouser Part Number 653-G5LE-14-DC5
Q2, Q3: BSS806NH6327XTSA1; SOT95P240X110-3N; Mouser Part Number 726-BSS806NH6327
R1, R2, R3, R5, R6, R7, R8, R10, R11, R13, R14, R15, R16, R17, R18, R19, R20, R21: R; R_1206_3216Metric_Pad1.30x1.75mm_HandSolder
R4: 10k; R_1206_3216Metric_Pad1.30x1.75mm_HandSolder
R12: 150ohm, 0.05w, min; R_1206_3216Metric_Pad1.30x1.75mm_HandSolder; Part Number RMCF1206JT300R
SW1: XA1E-BV302-R
StepperMotor1: StepperMotor1; PinHeader_1x04_P2.54mm_Vertical
StepperMotor2: StepperMotor2; PinHeader_1x04_P2.54mm_Vertical

Connections:
46_GPIO0_PC13: IC2.3 (IN_3); also elsewhere on the board
48_GPIO1_PC15: IC2.2 (IN_2); also elsewhere on the board
50_GPIO2_PD4: IC2.1 (IN_1); also elsewhere on the board
52_GPIO3_PD5: J10.2; also elsewhere on the board
54_GPIO4_PE3: Q3.1 (G); also elsewhere on the board
59_PWM0_D6: J5.1; also elsewhere on the board
61_PWM1_D5: J5.2; also elsewhere on the board
63_PWM2_D4: J7.1; also elsewhere on the board
65_PWM3_D3: J7.2; also elsewhere on the board
67_PWM4_D2: Q2.1 (G); also elsewhere on the board
73_ANALOG_A0: R15.2, R16.1; also elsewhere on the board
75_ANALOG_A1: R10.2, R11.1; also elsewhere on the board
+3.3V: R13.1; also elsewhere on the board
+5V: D1.1 (K), J6.7, J8.7, K1.5 (COIL_2), R1.1, R3.1, R4.1, R12.2, R18.1, R20.1; also elsewhere on the board
+24V: J9.1, J13.2, J13.4, K1.3 (NO); also elsewhere on the board
BATT_VIN: R15.1; also elsewhere on the board
EN1: J5.8, J7.8, R1.2, R2.1
GND: IC2.8 (GND), J6.2, J6.8, J8.2, J8.8, J13.1, Q2.2 (S), Q3.2 (S), R2.2, R5.2, R11.2, R14.2, R16.2, R17.2, R19.2, R21.2; also elsewhere on the board
MS1_1: J5.7, J7.7, R3.2, R17.1
MS2_1: J5.6, J7.6, R18.2, R19.1
unnamed: D1.2 (A), D2.1 (K), K1.2 (COIL_1), Q2.3 (D)
unnamed: D2.2 (A), R12.1
unnamed: IC2.14 (OUT_5), R8.1
unnamed: IC2.15 (OUT_6), R7.1
unnamed: IC2.16 (OUT_7), R6.1
unnamed: J9.2, R6.2
unnamed: J9.3, R7.2
unnamed: J9.4, R8.2
unnamed: J10.1, R4.2
unnamed: J10.3, R5.1
unnamed: J13.3, R10.1
unnamed: J13.5, Q3.3 (D), R13.2, R14.1
unnamed: K1.1 (COM), SW1.1, SW1.3
OA1_1: J6.4, StepperMotor1.3
OA1_2: J8.4, StepperMotor2.2
OA2_1: J6.3, StepperMotor1.4
OA2_2: J8.3, StepperMotor2.1
OB1_1: J6.5, StepperMotor1.2
OB1_2: J8.5, StepperMotor2.3
OB2_1: J6.6, StepperMotor1.1
OB2_2: J8.6, StepperMotor2.4
SPREAD1: J5.5, J7.5, R20.2, R21.1
VM: J6.1, J8.1, SW1.2, SW1.4

Notes on the sheet:
This voltage divider needs to be adjusted to measure the battery voltage
LED Driver
VCC RED YELLOW GREEN
1. Motor Drivers 2. H7 Mount 3. 24v to 5v 4. 5v to 3.3v 5. UT 6. Motor Wire mount 7. Relay mount 8. clamp sensor 9. encoder 10. linear transducer 11. Hard estop 12. main battery power in 13. Battery Monitor
1 BLUE - GND 2. BROWN - 24V 3. WHITE - OUTPUT - 0 to 10V 4. BLACK - 24V - Sets Fast Read Mode 5. GREY - Teach
This voltage divider needs to be adjusted so that the teach pin is given 2 volts
Stepper drivers TMC2209 SlicentStepSticks
This voltage divider needs to scale the 0 to 10v output of the sensor to the analog input range of the device

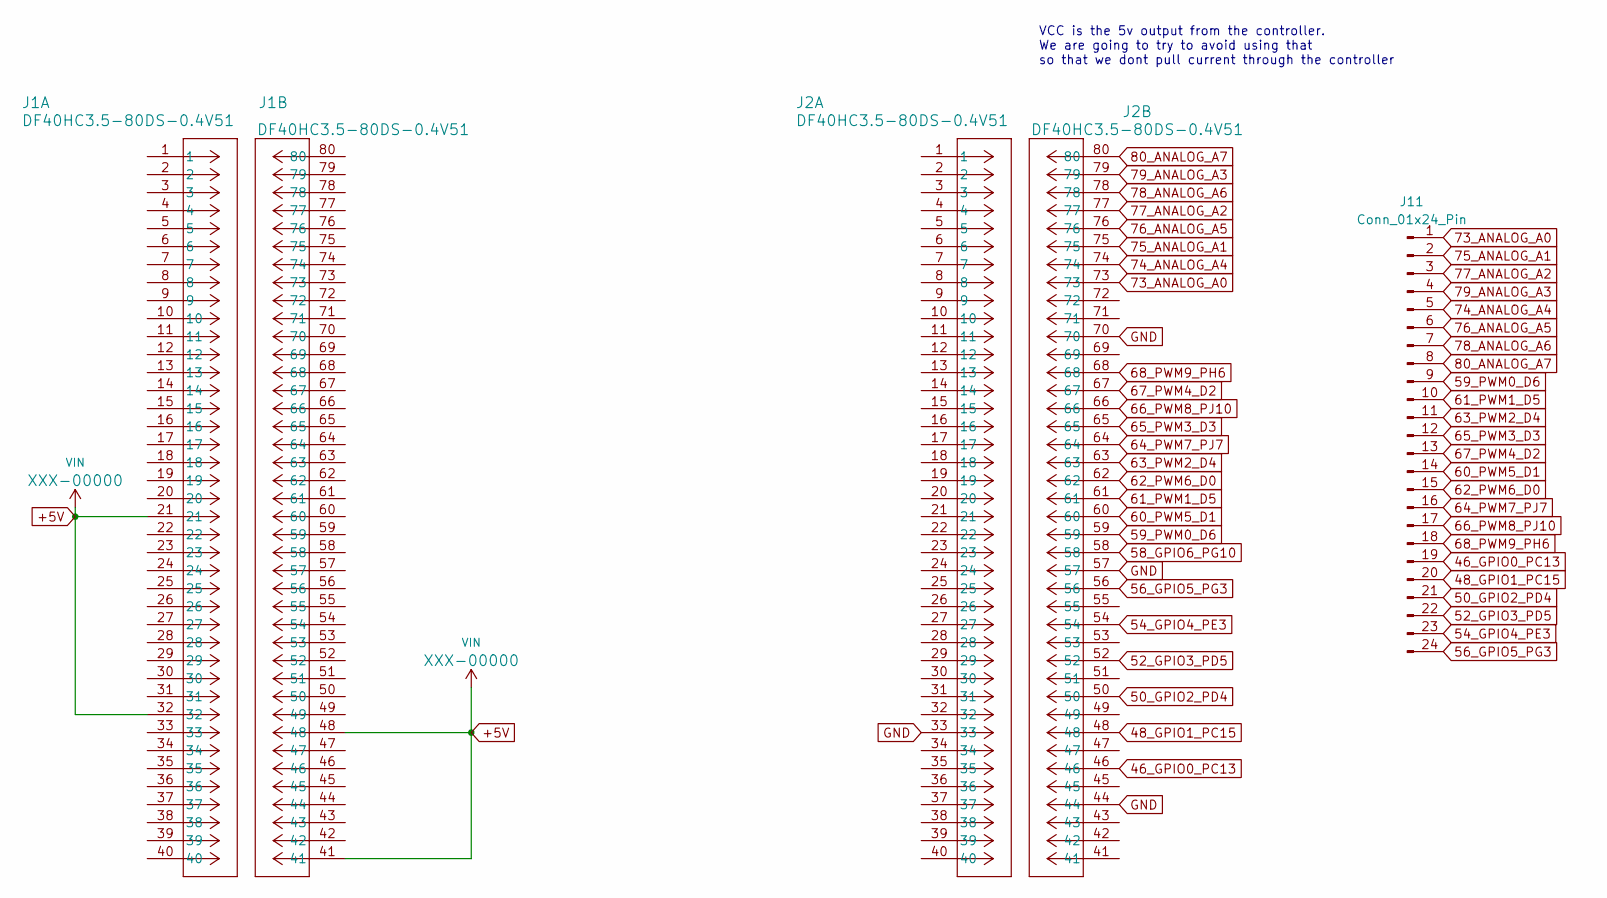
[picture p26: schematic Controller.kicad_sch]

Parts:
J1, J2: DF40HC3.5-80DS-0.4V51; DF40HC3580DS04V58
J11: Conn_01x24_Pin; PinHeader_1x24_P2.54mm_Vertical

Connections:
46_GPIO0_PC13: J2.46, J11.19; also elsewhere on the board
48_GPIO1_PC15: J2.48, J11.20; also elsewhere on the board
50_GPIO2_PD4: J2.50, J11.21; also elsewhere on the board
52_GPIO3_PD5: J2.52, J11.22; also elsewhere on the board
54_GPIO4_PE3: J2.54, J11.23; also elsewhere on the board
56_GPIO5_PG3: J2.56, J11.24; also elsewhere on the board
58_GPIO6_PG10: J2.58; also elsewhere on the board
59_PWM0_D6: J2.59, J11.9; also elsewhere on the board
60_PWM5_D1: J2.60, J11.14; also elsewhere on the board
61_PWM1_D5: J2.61, J11.10; also elsewhere on the board
62_PWM6_D0: J2.62, J11.15; also elsewhere on the board
63_PWM2_D4: J2.63, J11.11; also elsewhere on the board
64_PWM7_PJ7: J2.64, J11.16; also elsewhere on the board
65_PWM3_D3: J2.65, J11.12; also elsewhere on the board
66_PWM8_PJ10: J2.66, J11.17; also elsewhere on the board
67_PWM4_D2: J2.67, J11.13; also elsewhere on the board
68_PWM9_PH6: J2.68, J11.18; also elsewhere on the board
73_ANALOG_A0: J2.73, J11.1; also elsewhere on the board
74_ANALOG_A4: J2.74, J11.5; also elsewhere on the board
75_ANALOG_A1: J2.75, J11.2; also elsewhere on the board
76_ANALOG_A5: J2.76, J11.6; also elsewhere on the board
77_ANALOG_A2: J2.77, J11.3; also elsewhere on the board
78_ANALOG_A6: J2.78, J11.7; also elsewhere on the board
79_ANALOG_A3: J2.79, J11.4; also elsewhere on the board
80_ANALOG_A7: J2.80, J11.8; also elsewhere on the board
+5V: J1.21, J1.32, J1.41, J1.48; also elsewhere on the board
GND: J2.33, J2.44, J2.57, J2.70; also elsewhere on the board

Notes on the sheet:
VCC is the 5v output from the controller. We are going to try to avoid using that so that we dont pull current through the controller

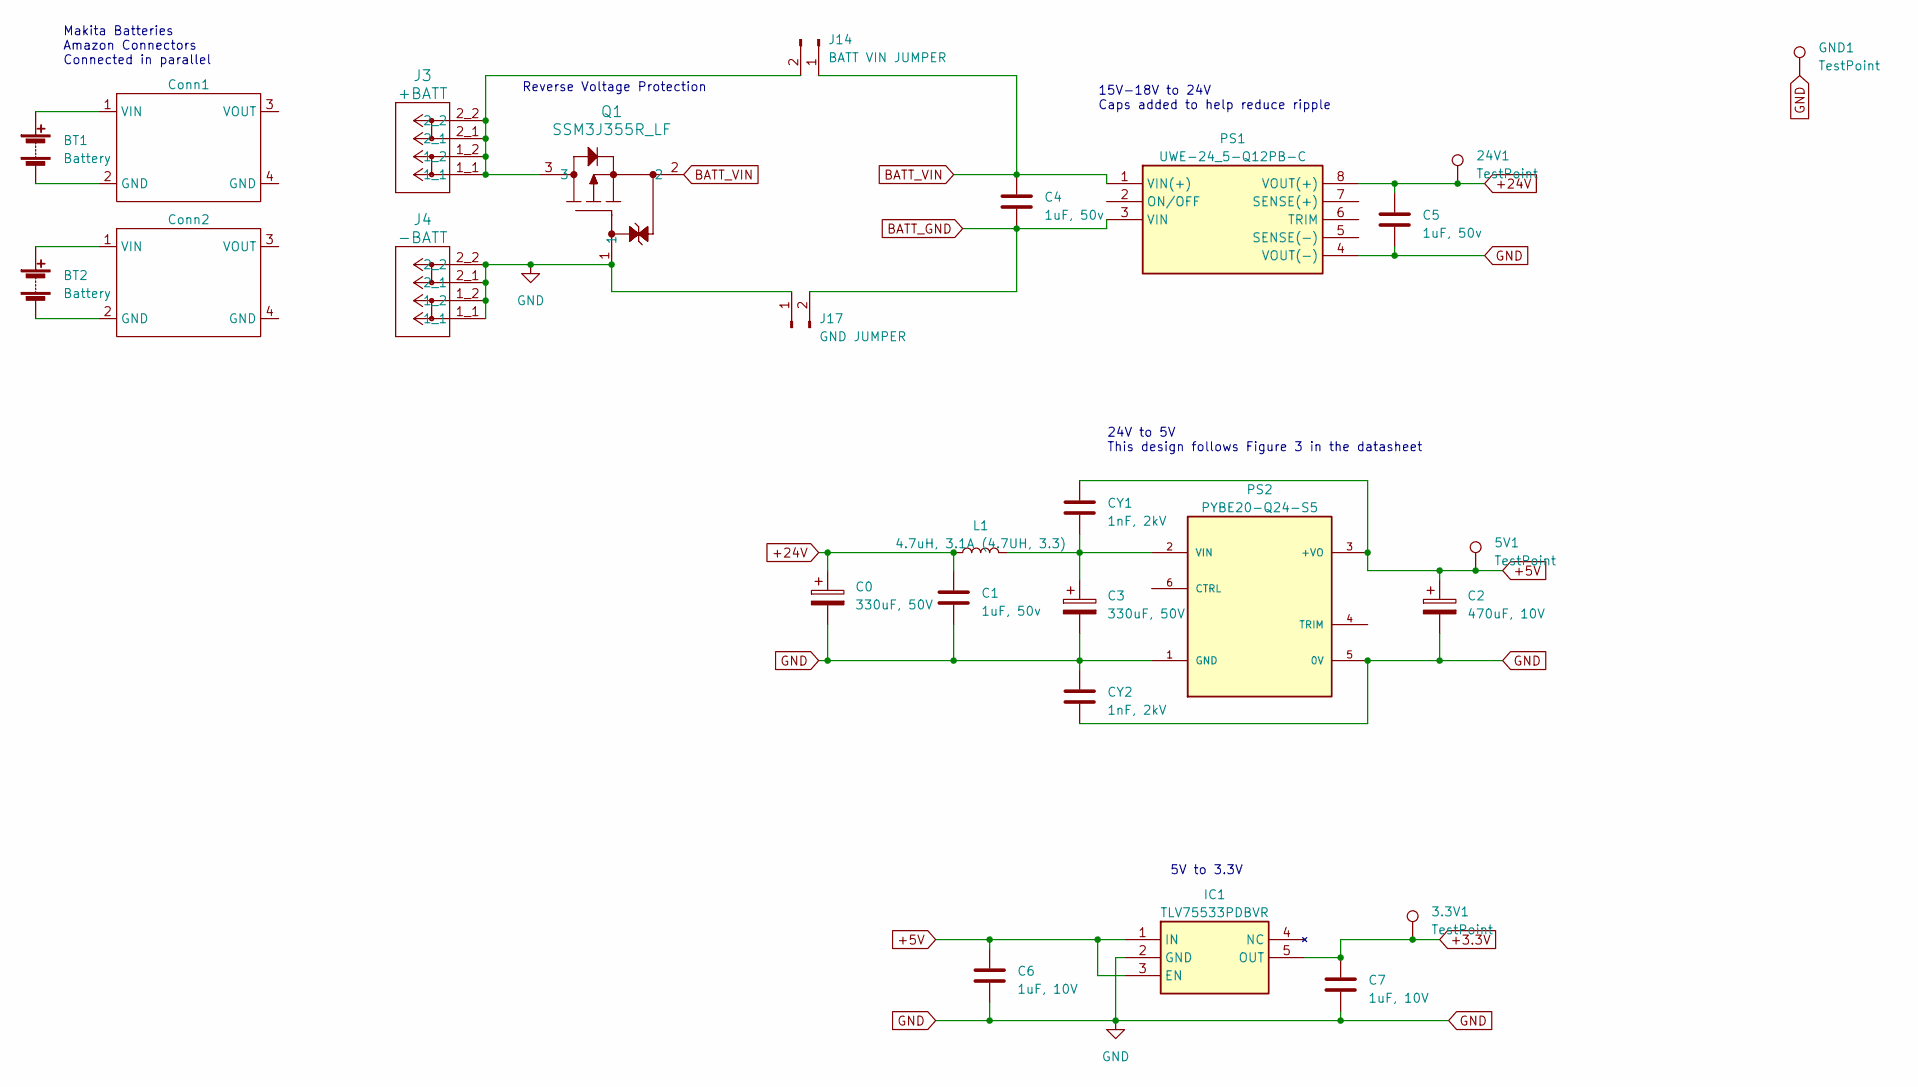
[picture p27: schematic PowerSystem.kicad_sch]

Parts:
3.3V1, 5V1, 24V1: TestPoint; TestPoint_Pad_D2.5mm
BT1, BT2: Battery
C0, C3: 330uF, 50V; CP_Radial_D10.0mm_P5.00mm; Part Number ECA-1HM331B
C1, C4, C5: 1uF, 50v; C_0805_2012Metric_Pad1.18x1.45mm_HandSolder; Part Number CL21B105KBFNNNG
C2: 470uF, 10V; CP_EIA-7343-15_Kemet-W_Pad2.25x2.55mm_HandSolder; Part Number 293D477X9010E2TE3
C6, C7: 1uF, 10V; C_0805_2012Metric_Pad1.18x1.45mm_HandSolder; Part Number CL21B105KPFNNNE
CY1, CY2: 1nF, 2kV; C_1812_4532Metric_Pad1.57x3.40mm_HandSolder; Part Number C1812C102KGRACAUTO
Conn1, Conn2: (no value)
GND1: TestPoint; TestPoint_Pad_D2.5mm
IC1: TLV75533PDBVR; SOT95P280X145-5N; Mouser Part Number 595-TLV75533PDBVR
J3: +BATT; 2604-1102
J4: -BATT; 2604-1102
J14: BATT VIN JUMPER; PinHeader_1x02_P2.54mm_Vertical
J17: GND JUMPER; PinHeader_1x02_P2.54mm_Vertical
L1: 4.7uH, 3.1A (4.7UH, 3.3); IND_XGL4018_COC-M; Part Number XGL4018-472MEC
PS1: UWE-24_5-Q12PB-C; UWE245Q12PBC; Mouser Part Number 580-UWE-24/5-Q12PB-C
PS2: PYBE20-Q24-S5; CONV_PYBE20-Q24-S5
Q1: SSM3J355R_LF; SOT-23F_TOS

Connections:
+3.3V: 3.3V1.1, C7.1, IC1.5 (OUT); also elsewhere on the board
+5V: 5V1.1, C2.1, C6.1, CY1.1, IC1.1 (IN), IC1.3 (EN), PS2.3 (+VO); also elsewhere on the board
+24V: 24V1.1, C0.1, C1.1, C5.1, L1.1, PS1.8 (VOUT(+)); also elsewhere on the board
BATT_GND: C4.2, J17.2, PS1.3 (VIN)
BATT_VIN: C4.1, J14.1, PS1.1 (VIN(+)), Q1.2; also elsewhere on the board
GND: C0.2, C1.2, C2.2, C3.2, C5.2, C6.2, C7.2, CY2.1, CY2.2, GND1.1, IC1.2 (GND), J4.1_1, J4.1_2, J4.2_1, J4.2_2, J17.1, PS1.4 (VOUT(-)), PS2.1 (GND), PS2.5 (0V), Q1.1; also elsewhere on the board
unnamed: BT1.1 (+), Conn1.1 (VIN)
unnamed: BT1.2 (-), Conn1.2 (GND)
unnamed: BT2.1 (+), Conn2.1 (VIN)
unnamed: BT2.2 (-), Conn2.2 (GND)
unnamed: J3.1_1, J3.1_2, J3.2_1, J3.2_2, J14.2, Q1.3
unnamed: C3.1, CY1.2, L1.2, PS2.2 (VIN)

Notes on the sheet:
Makita Batteries Amazon Connectors Connected in parallel
5V to 3.3V
15V-18V to 24V Caps added to help reduce ripple
Reverse Voltage Protection
24V to 5V This design follows Figure 3 in the datasheet
