jaowens14/GR-LRR-PCB/GR-LRR-PCB_A1/GR-LRR-PCB.kicad_pcb

## KiCad design OLD REVS/GR-LRR-PCB_A1/GR-LRR-PCB.kicad_pcb (continued)

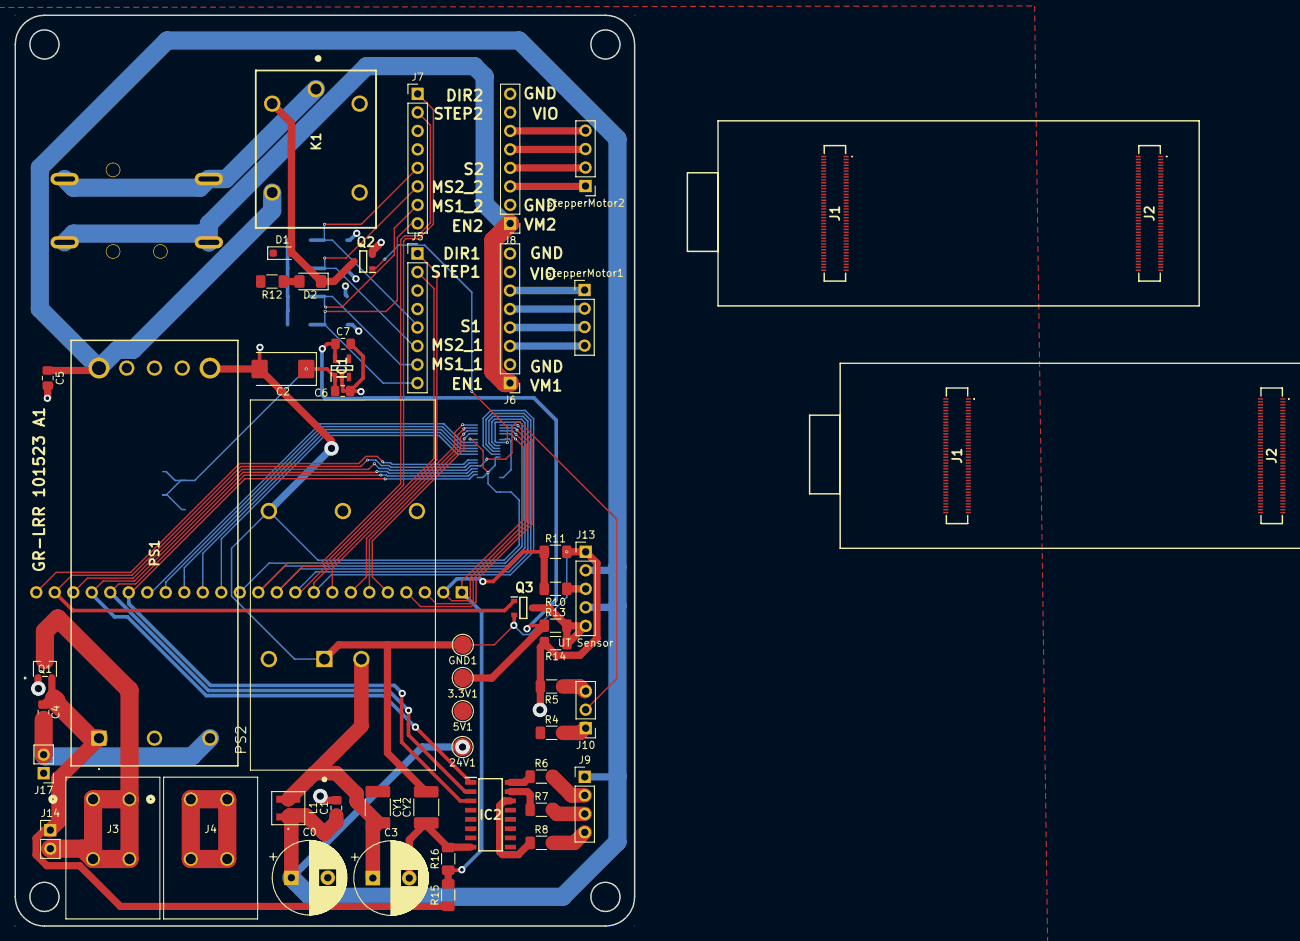
[picture p28: board GR-LRR-PCB.kicad_pcb from above]

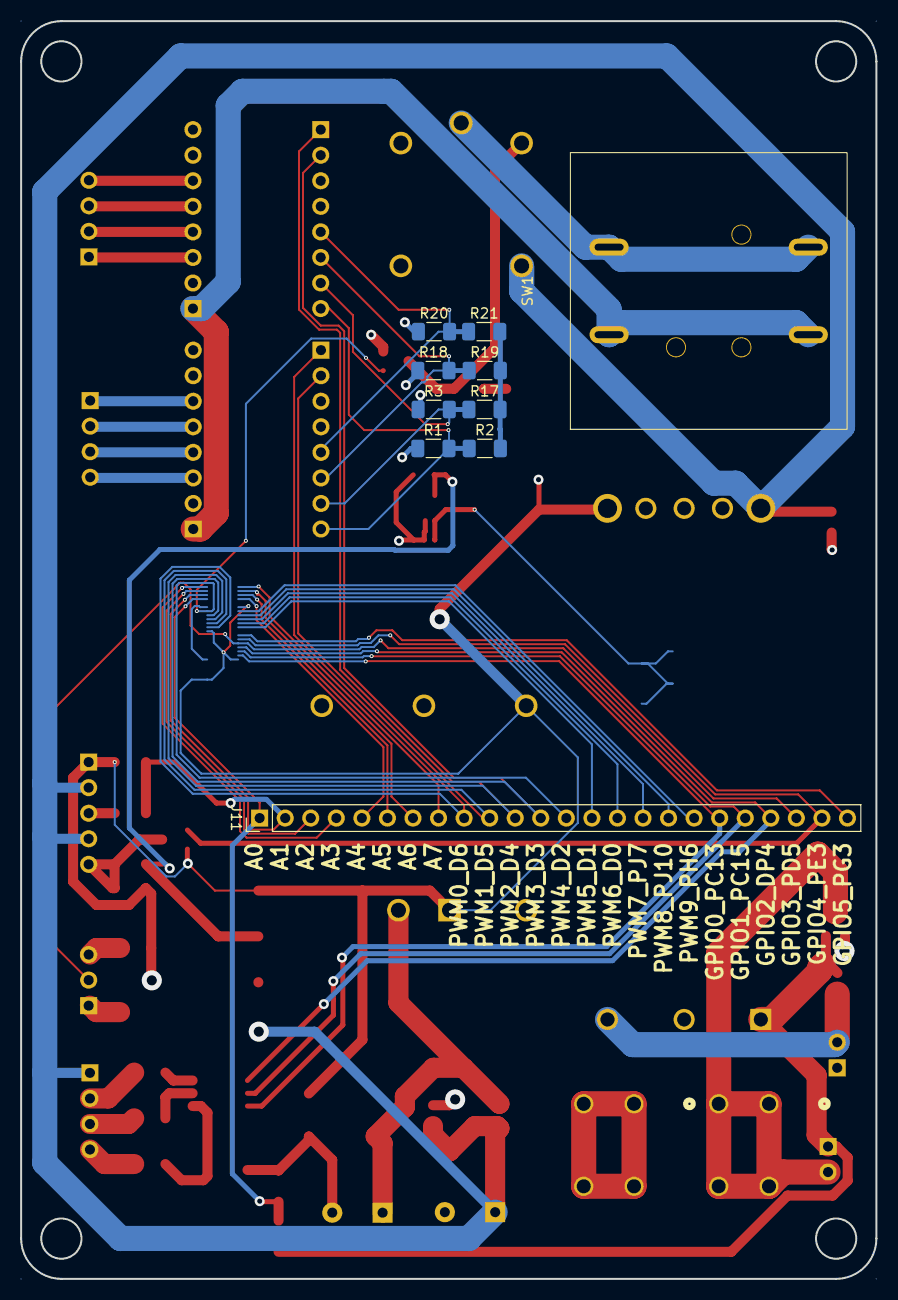
[picture p29: board GR-LRR-PCB.kicad_pcb from below]

Board: 2 copper layers, 85.0 x 125.0 mm, 64 parts (10 on the bottom side), 59 nets.

Other parts of the board:
J1#2, J2#2: DF40HC3.5-80DS-0.4V51; DF40HC3580DS04V58

Their connections:
46_GPIO0_PC13: J2#2.46; also elsewhere on the board
48_GPIO1_PC15: J2#2.48; also elsewhere on the board
50_GPIO2_PD4: J2#2.50; also elsewhere on the board
52_GPIO3_PD5: J2#2.52; also elsewhere on the board
54_GPIO4_PE3: J2#2.54; also elsewhere on the board
56_GPIO5_PG3: J2#2.56; also elsewhere on the board
58_GPIO6_PG10: J2#2.58; also elsewhere on the board
59_PWM0_D6: J2#2.59; also elsewhere on the board
60_PWM5_D1: J2#2.60; also elsewhere on the board
61_PWM1_D5: J2#2.61; also elsewhere on the board
62_PWM6_D0: J2#2.62; also elsewhere on the board
63_PWM2_D4: J2#2.63; also elsewhere on the board
64_PWM7_PJ7: J2#2.64; also elsewhere on the board
65_PWM3_D3: J2#2.65; also elsewhere on the board
66_PWM8_PJ10: J2#2.66; also elsewhere on the board
67_PWM4_D2: J2#2.67; also elsewhere on the board
68_PWM9_PH6: J2#2.68; also elsewhere on the board
73_ANALOG_A0: J2#2.73; also elsewhere on the board
74_ANALOG_A4: J2#2.74; also elsewhere on the board
75_ANALOG_A1: J2#2.75; also elsewhere on the board
76_ANALOG_A5: J2#2.76; also elsewhere on the board
77_ANALOG_A2: J2#2.77; also elsewhere on the board
78_ANALOG_A6: J2#2.78; also elsewhere on the board
79_ANALOG_A3: J2#2.79; also elsewhere on the board
80_ANALOG_A7: J2#2.80; also elsewhere on the board
+5V: J1#2.21, J1#2.32, J1#2.41, J1#2.48; also elsewhere on the board
GND: J2#2.33, J2#2.44, J2#2.57, J2#2.70; also elsewhere on the board
