jaowens14/GR-LRR-PCB/GR-LRR-ESTOP-PCB/GR-LRR-ESTOP-PCB.kicad_pcb

## KiCad design OLD REVS/GR-LRR-ESTOP-PCB/GR-LRR-ESTOP-PCB.kicad_pcb (2024-03-15, an earlier design)

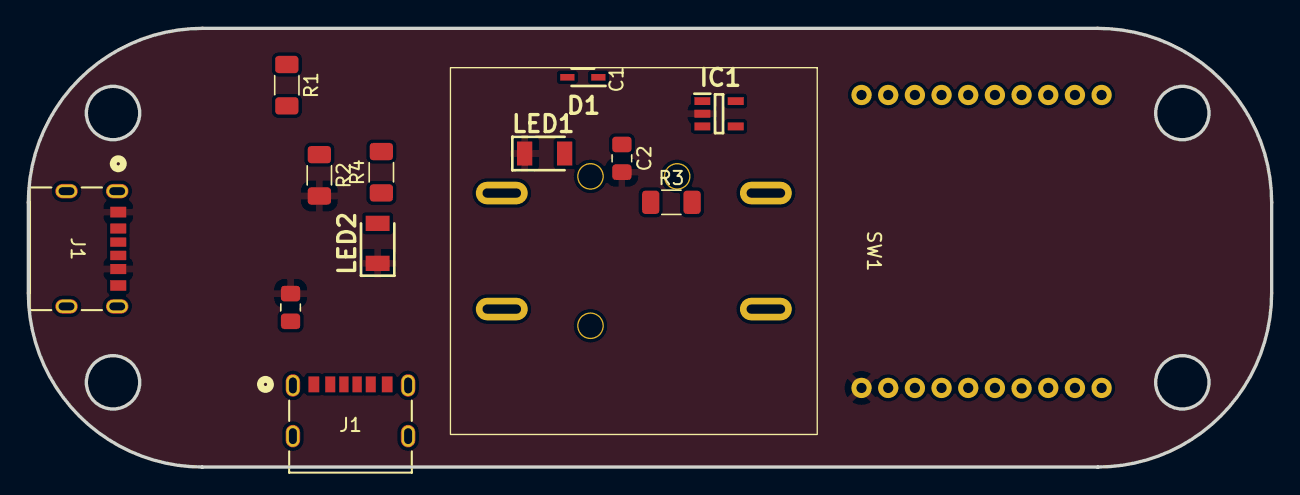
[picture p30: board GR-LRR-ESTOP-PCB.kicad_pcb from above]

Board: 2 copper layers, 93.2 x 32.9 mm, 14 parts (1 on the bottom side), 8 nets, no tracks yet.

Parts:
C1, C2: 1uF, 10V; C_0805_2012Metric_Pad1.18x1.45mm_HandSolder
D1: ZLLS400TA; SOD2513X120N
IC1: TLV75533PDBVR; SOT95P280X145-5N
J1, J1#2: 10164359-00011LF; CONN_10164359-00011LF_AMP
LED1, LED2: QTLP650C2TR; LEDC3216X130N
R1, R2: 1k; R_1206_3216Metric_Pad1.30x1.75mm_HandSolder
R3, R4: 86ohm, 1/10w; R_1206_3216Metric_Pad1.30x1.75mm_HandSolder
SW1: XA1E-BV302-R
U1: XB3-24AST-J

Connections:
+3.3V: C2.1, IC1.5 (OUT), R3.2, SW1.1, U1.1 (VCC)
+5V: D1.2 (A), J1#2.A12 (VBUS), J1#2.B5 (VBUS)
GND: C1.2, C2.2, IC1.2 (GND), J1#2.A9 (GND), J1#2.B12 (GND), LED1.1 (K), LED2.1 (K), R2.2, U1.10 (GND)
unnamed: C1.1, D1.1 (K), IC1.1 (IN), IC1.3 (EN)
unnamed: LED1.2 (A), R3.1
unnamed: LED2.2 (A), R4.1
unnamed: R1.1, SW1.2
unnamed: R1.2, R2.1, R4.2, U1.20 (AD0/DIO0)
