jaowens14/GR-LRR-PCB/(commit log)

2023-10-13 need to add more blocks
    [GR-LRR-PCB.kicad_pcb, GR-LRR-PCB.kicad_sch]
2023-10-17 selected parts for power side
    [20M1_ATM.step, 2604-1102.stp, Control.kicad_sch, DF40HC(3.5)-80DS.stp, GR-LRR-PCB.kicad_pcb, GR-LRR-PCB.kicad_sch, IHLP1212AEERR33M11.STEP, IO.kicad_sch]
2023-10-23 starting first layout
    [Control.kicad_sch, Controller.kicad_sch, GR-LRR-PCB.csv, GR-LRR-PCB.kicad_pcb, GR-LRR-PCB.kicad_sch, IO.kicad_sch, PowerSystem.kicad_sch]
2023-10-25 new smaller layout
    [Controller.kicad_sch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]
2023-10-25 new gerbers
    [GR-LRR-PCB-B_Cu.gbr, GR-LRR-PCB-B_Mask.gbr, GR-LRR-PCB-B_Paste.gbr, GR-LRR-PCB-B_Silkscreen.gbr, GR-LRR-PCB-Edge_Cuts.gbr, GR-LRR-PCB-F_Cu.gbr, GR-LRR-PCB-F_Mask.gbr, GR-LRR-PCB-F_Paste.gbr]
2023-10-31 added step files
    [G5LE-14-DC5.stp, GR-LRR-PCB.kicad_pcb, UWE-24_5-Q12PB-C.stp, XA1E-BV302-R.stp]
2023-12-06 power and control boards
    [047700.stp, 20M1_ATM.step, 2604-1102.stp, 55001998-04-PRT.STEP, ABX00042.step, CAP_PKPZ_12P5X20_LOW_RUB.step, Control.kicad_sch, Controller.kicad_sch]
2024-03-15 moving to two enclosures
    [10164359-00011LF.STEP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]
2024-03-25 low and high V boards done
    [047700.stp, 20M1_ATM.step, 2604-1102.stp, 696108003002.stp, BOARDOUTLINES.SLDPRT, CAP_PKPZ_12P5X20_LOW_RUB.step, CAP_YX_8X11P5_RUB.step, DF40HC(3.5)-80DS.stp]
2024-05-09 purchasing A3 power
    [CM4_GPIO.kicad_sch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]
2024-05-12 finished routing
    [CM4_GPIO.kicad_sch, CM4_HighSpeed.kicad_sch, GR-LRR-CONTROL-PCB.kicad_pcb, GR-LRR-CONTROL.kicad_sch, GR-LRR-GLUE-SHOVEL.kicad_pcb, GR-LRR-GLUE-SHOVEL.kicad_sch, USB2-HUB.kicad_sch, temp.kicad_pcb]
2024-05-13 ordered power and control A4
    [CM4_GPIO.kicad_sch, Controller.kicad_sch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]
