jaowens14/GR-LRR-PCB/(notices)

Notices in the files:
OLD REVS/GR-LRR-CONTROL-PCB/CM4IOv5.kicad_sch:
© 2020-2022 Raspberry Pi Ltd (formerly Raspberry Pi (Trading) Ltd.)
OLD REVS/avid_components/2604-1102.stp:
author */ ('License CC BY-ND 4.0'),
